bogdan-folea/explorer/doc/abstract.tex

\thispagestyle{empty}
\begin{flushleft}

\vspace*{100px}

\justify\large\textit{
    Lucrarea de față are în vedere proiectarea, asamblarea și programarea unui robot telecomandat semiautonom având la bază un sistem de operare în timp real, cu scopul de a colecta informații despre mediul înconjurător și a le transmite mai departe către un calculator. Acest lucru a fost realizat în scopul explorării unor medii în care accesul uman este restricţionat.
}

\end{flushleft}
