bogdan-folea/explorer/doc/coperta.tex

\thispagestyle{empty}
\begin{center}

{\large
    UNIVERSITATEA POLITEHNICA DIN BUCUREȘTI \\
    FACULTATEA DE AUTOMATICĂ ȘI CALCULATOARE \\
    DEPARTAMENTUL DE CALCULATOARE \\
}

\vspace{\stretch{1}}

\begin{tabular}{m{0.28\linewidth}m{0.4\linewidth}m{0.22\linewidth}}
%\flushleft 
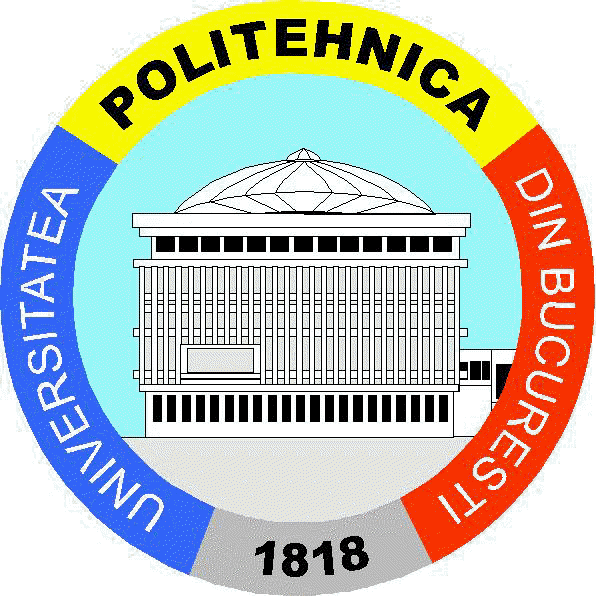
[picture p1: doc/figuri/upb-logo.png]
\center  &
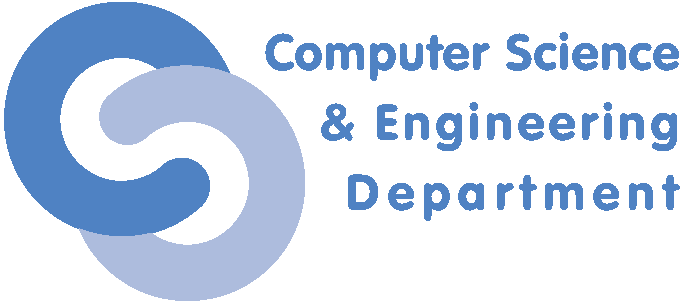
[picture p2: doc/figuri/cs-logo.png]
\center  &
%\flushright 
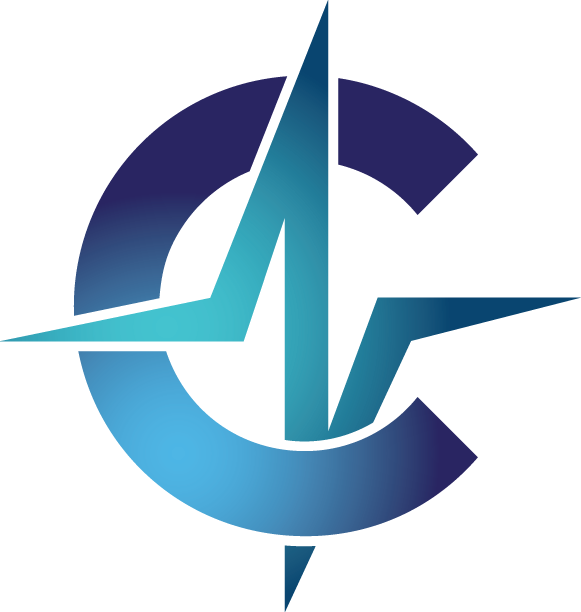
[picture p3: doc/figuri/acs-logo.png]
\center 
\end{tabular}

\vspace{\stretch{12}}

{\LARGE
	\textbf{LUCRARE DE DIPLOMĂ}\\
	\vspace{\stretch{3}}
	\textbf{Robot Explorator}
}

\vspace{\stretch{8}}

{\large
    \begin{multicols}{2}
        \begin{flushleft}
        \textbf{Coordonatori științifici:}\\
        Prof.dr.ing. Mariana Mocanu\\
        \fbox{Prof.dr.ing. Șerban Petrescu}
        \end{flushleft}
    \columnbreak
        \begin{flushright}
        \textbf{Absolvent:}\\
        Bogdan Folea
        \end{flushright}
    \end{multicols}
}

\vspace{\stretch{20}}

{\large
    \textbf{BUCUREȘTI\-\ \-\ \-\ }\\
    - 2017 -
}

\end{center}
