bogdan-folea/explorer/doc/bibliografie.tex

\clearpage
\addcontentsline{toc}{chapter}{Bibliografie}

\begin{thebibliography}{99}

    % Introducere
    \bibitem{heron}{
        N. Sharkey, \emph{A programmable robot from AD 60}, New Scientist, 2007.
    }
    \bibitem{curiosity}{
        M. Wall, 
        \emph{A Glitch Nearly Killed NASA's Curiosity Rover After 6 Months on Mars}, 2017. Disponibil pe 
        \href{https://www.space.com/36841-mars-rover-curiosity-computer-glitch-60-minutes.html}{www.space.com} (15.05.2017)
	}
    \bibitem{djedi}{
        R. Richardson, et al.  
        \emph{The “Djedi” Robot Exploration of the Southern Shaft of the Queen's Chamber in the Great Pyramid of Giza, Egypt}, Journal of Field Robotics 30(3): 323–348, 2013.
	}
    \bibitem{wolf}{
        M. Wolf, 
        \emph{High-Performance Embedded Computing: Applications in Cyber-Physical Systems and Mobile Computing}, 
        Second Edition, Elsevier, 2014
    }
    \bibitem{kraeling}{
        R. Oshana, M. Kraeling, 
        \emph{Software Engineering for Embedded Systems: Methods, Practical Techniques, and Applications}, 
        Elsevier, 2013
    }
	
	% Arhitectura hardware
    \bibitem{toulson}{
        R. Toulson, T. Wilmshurst, 
        \emph{Fast and Effective Embedded Systems Design -- Applying the ARM mbed}, 
        Elsevier, 2012
    }
    
    % Implementarea software
    \bibitem{walls}{
        C. Walls, 
        \emph{Embedded Software: The Works}, 
        Second Edition, Elsevier, 2012
    }
    \bibitem{barr}{
        M. Barr, 
        \emph{Programming Embedded Systems in C and C++}, 
        O'Reilly, 1999
    }
    \bibitem{ritchie}{
        B. Kernighan, D. Ritchie, 
        \emph{The C programming Language}, 
        Second Edition, Prentice-Hall, 1988
    }
    \bibitem{noergaard}{
        T. Noergaard, 
        \emph{Embedded Systems Architecture}, 
        Elsevier, 2013
    }
    \bibitem{freertos1}{
        R. Barry, 
        \emph{Using the FreeRTOS Real Time Kernel}, 
        Real Time Engineers Ltd, 2010
    }
    \bibitem{lee}{
        E. Lee, S. Seshia, 
        \emph{Introduction to Embedded Systems -- A Cyber-Physical Systems Approach}, 
        LeeSeshia.org, 2011
    }
    \bibitem{cortexm}{
        J. Yiu, 
        \emph{The Definitive Guide to ARM Cortex--M3 and Cortex--M4 Processors}, 
        Third Edition, Elsevier, 2014
    }
    \bibitem{freertos2}{
        R. Barry, 
        \emph{Mastering the FreeRTOS Real Time Kernel}, 
        Real Time Engineers Ltd, 2016
    }

\end{thebibliography}
