bogdan-folea/explorer/doc/anexe/circuit.tex

\chapter{Schema electrică}

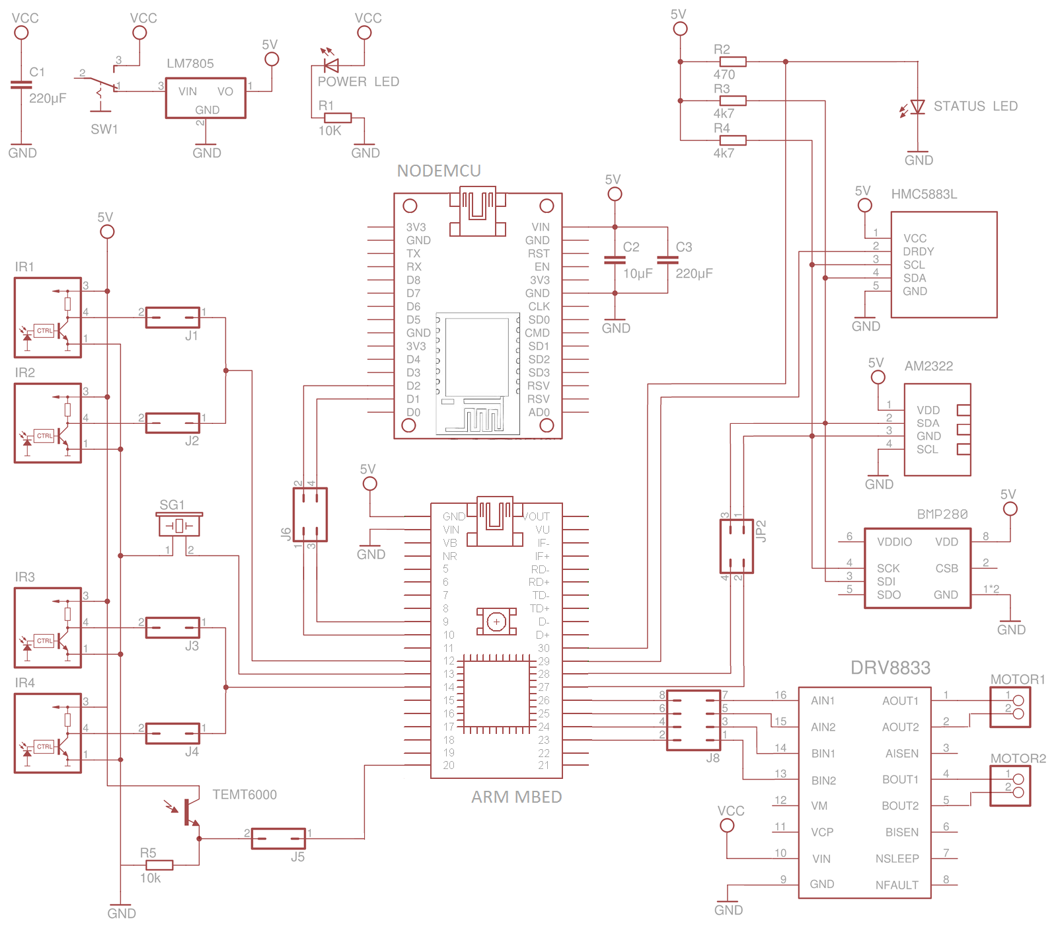
[picture p4: doc/figuri/schema.png]
\center
