bogdan-folea/explorer/doc/lucrare.pdf

### UNIVERSITATEA POLITEHNICA DIN BUCURES, TI FACULTATEA DE AUTOMATICA S ˘ , I CALCULATOARE DEPARTAMENTUL DE CALCULATOARE


## LUCRARE DE DIPLOMA˘

## Robot Explorator

Coordonatori s,tiint,ifici:

### Prof.dr.ing. Mariana Mocanu Prof.dr.ing. S, erban Petrescu

Absolvent:

### Bogdan Folea

BUCURES, TI
- 2017 -

Lucrarea de fat,˘a are în vedere proiectarea, asamblarea s,
i programarea unui
robot telecomandat semiautonom având la baz˘a un sistem de operare în timp real, cu scopul de a colecta informat,

ii despre mediul înconjur˘ator s, i a
le transmite mai departe c˘atre un calculator. Acest lucru a fost realizat în scopul explor˘arii unor medii în care accesul uman este restric¸tionat.

# Cuprins

1 Introducere | 3
2 Arhitectura hardware | 9

Cuprins

3 Implementarea software | 23
4 Rezultate experimentale | 35
5 Concluzii s,i dezvoltare ulterioar ˘a | 37
Bibliografie | 38
List ˘a de figuri | 39
Anexa A Schema electric ˘a | 41

# Capitolul 1

# Introducere

Istoria robot,ilor îs, i are originile în Antichitatea clasic ˘a, fapt dovedit de scrierile matematicianului Heron din Alexandria, care stau m ˘arturie existent,ei unor mecanisme automate [1] bazate pe principii mecanice. Fascinat,ia pentru construct,ia unor astfel de mecanisme s-a manifestat s, i în perioada Renas,terii italiene, prin schit,ele lui Leonardo da Vinci s, i mai târziu în timpul Revolut,iei Industriale.

Momentul de cotitur ˘a în acest domeniu îl constituie dezvoltarea electronicii s, i aparit,ia circuitelor integrate digitale, în urma c ˘aruia a s-a cristalizat s,tiint,a care se ocup ˘a cu proiectarea, construct,ia s, i operarea robot,ilor, precum s, i sistemele de control, react,ie la stimuli exteriori s, i procesare a informat,iei, sub numele de robotic ˘a.

Aceast ˘a ramur ˘a a tehnicii a cunoscut o ascensiune vizibil ˘a în trecutul recent, o dat ˘a cu aparit,ia Inteligent,ei Artificiale s, i a Internetului Obiectelor (engl. IoT¹ ),
conducând efectiv la integrarea circuitelor electronice cu sitemul de locomot,ie al robotului s, i posibilitatea de a conecta între ele mai multe astfel de sisteme autonome prin intermediul diverselor protocoale de comunicat,ii.

În prezent, datorit ˘a progreselor rapide înregistrate în domeniu, robot,ii au ajuns s ˘a îndeplineasc ˘a funct,ii din ce în ce mai diverse. Printre acestea se num ˘ar ˘a fabricarea de automobile, unde au ajuns s ˘a aib ˘a o pondere tot mai mare, sub forma liniilor de product,ie complet automatizate, au ajuns s ˘a aib ˘a o pondere tot mai mare pe parcursul ultimelor decenii. De asemenea, robot,ii au ajuns s ˘a fie folosit,i extensiv s, i la împachetarea produselor alimentare, transportul m ˘arfurilor

1
Internet of Things

Capitolul 1. Introducere

în interiorul spat,iilor de depozitare, recolta anumitor culturi de fructe, fabricarea cablajelor imprimate, precum s, i în exploat ˘ari miniere. Pe lâng ˘a tipurile de robot,i industriali enumerate mai devreme, s-au dezvoltat robot,i care pot duce independent la îndeplinire sarcini domestice ca tunsul ierbii sau aspirarea covoarelor s, i, nu în ultimul rând, robot,i umanoizi, care au scopul de a imita comportamentul oamenilor sau p ˘art,i din acesta, de exemplu mersul biped.

Spre deosebire de situat,iile ment,ionate anterior, unde robot,ii sunt folosit,i cu scopul de a spori productivitatea unor activit ˘at,i ce pot fi efectuate de agent,i umani, exist ˘a împrejur ˘ari, care, prin natura lor, care impun folosirea unui robot. Poate cel mai bun exemplu este explorarea mediilor fizic inaccesibile oamenilor, aflate la mare distant, ˘a sau având indici de risc care dep ˘as, esc valori considerate admise, punând astfel în pericol o eventual ˘a intervent,ie uman ˘a. Câteva exemple sunt interiorul conductelor, spat,iul cosmic s, i mediile vulcanice sau puternic radioactive. Robot,ii special construit,i cu scopul de a explora astfel de medii se încadreaz ˘a în categoria robot,ilor exploratori.

## 1.1 Motivat,ie

Nivelul actual de dezvoltare a roboticii conduce la o popularitate în cres,tere a robot,ilor exploratori în rândul comunit ˘at,ii s,tiint,ifice s, i ingineres,ti. Fie c ˘a este vorba despre robot,i exploratori teres,tri, satelit,i artificiali sau drone, utilit ˘at,ile acestora sunt nenum ˘arate s, i se reflect ˘a în num ˘arul impresionant de cercet ˘ari privind explorarea spat,iilor de orice natur ˘a s, i fascinat,ia pe care o exercit ˘a asupra unei vaste categorii de oameni. Caracteristice acestor robot,i sunt sistemele complicate necesare pentru a îndeplini chiar sarcini foarte simple, acoperind o multitudine de discipline diferite printre care se num ˘ar ˘a mecanica, electronica, telecomunicat,iile s, i programarea.

La baza complexit ˘at,ii robot,ilor exploratori st ˘a o varietate de constrângeri care se manifest ˘a în moduri diferite în fiecare caz în parte. În particular, o dron ˘a are nevoie de m ˘asur ˘atori foarte precise ale înclin ˘arii s, i accelerat,iei, precum s, i de un metod ˘a eficient ˘a de anulare a zgomotului, în timp ce calitatea cea mai important ˘a a unui robot destinat explor ˘arii spat,iului cosmic este fiabilitatea. Un exemplu elocvent în acest caz este robotul Curiosity al Agent,iei Spat,iale Americane (engl. NASA²
), lansat în noiembrie 2011 pentru a explora planeta Marte.

2National Aeronautics and Space Administration

1.1. Motivat,ie

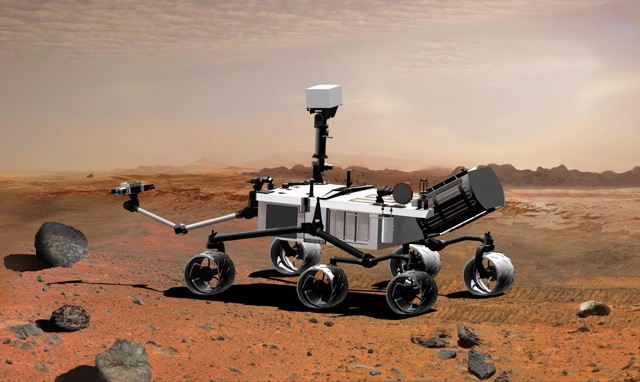
[picture p5: figure]

Figura 1.1: Robotul explorator Curiosity al NASA

La doar s, ase luni de la aterizarea acestuia, o eroare în memoria pilotului principal, combinat ˘a cu defectarea simultan ˘a a mecanismelor de sigurant, ˘a a condus la un potent,ial dezastru [2] însemnând pierderea definitiv ˘a a întregii investit,ii de 2,5 miliarde de dolari americani.

Comun ˘a tuturor sistemelor mai sus amintite este constrângerea de timp real (engl. real-time constraint) la care sunt supuse, definit ˘a garant,ia r ˘aspunsului la un stimul exterior înaintea unui termen limit ˘a prestabilit, indiferent de înc ˘arcarea sistemului. Solut,ia elegant ˘a la aceast ˘a problem ˘a este oferit ˘a de sistemele de operare în timp real (engl. RTOS³
).

Dezvoltarea în ultimul deceniu a sistemelor de operare în timp real se datoreaz ˘a în mare parte cres,terii puterii de procesare a microcontrollerelor, rezultând în folosirea mai eficient ˘a a timpului de calcul. Întrucât o schimbare de context⁴ dureaz ˘a foarte put,in (ordinul microsecundelor), sistemele de operare actuale nu mai sunt constrânse de frecvent,a cu care apare, ceea ce conduce la un timp de r ˘aspuns îmbun ˘at ˘at,it semnificativ.

În momentul de fat, ˘a exist ˘a o multitudine de astfel de sisteme de operare, sub licent, ˘a proprietar ˘a sau open source. Dintre acestea din urm ˘a cel mai popular este FreeRTOS, dezvoltat de Real Time Engineers Ltd., a c ˘arui descriere detaliat ˘a se g ˘ases,te în lucrarea de fat, ˘a la capitolul aferent. Acesta prezint ˘a un num ˘ar mare de avantaje care îl recomand ˘a, printre care faptul c ˘a e orientat pe evenimente, simplitatea interfet,ei de acces (engl. API⁵
), documentat,ia clar˘a s, i abundent ˘a, precum s, i suportul on-line de calitate.

3Real-Time Operating System
4Schimbarea execu¸tiei unui proces cu un altul pe procesor 5Application Programming Interface

Capitolul 1. Introducere

Posibilitatea de a utiliza acest sistem de operare în timp real, flexibil s, i asincron, la baza unui robot explorator în scopul de a folosi eficient timpul de calcul s, i a obt,ine un timp bun de r ˘aspuns la comenzi sau stimuli exteriori constituie motivat,ia din spatele realiz ˘arii acestui proiect.

## 1.2 Scopul lucr ˘arii

Lucrarea de fat, ˘a are drept scop proiectarea, asamblarea s, i programarea unui robot explorator operat de la distant, ˘a, destinat mediului terestru. Acesta trebuie s ˘a m ˘asoare o varietate de parametri caracteristici mediului înconjur ˘ator precum temperatura, presiunea, umiditatea s, i intensitatea luminii ambientale s, i s ˘a transmit ˘a datele operatorului. În plus, este necesar ca acesta s ˘a react,ioneze autonom în situat,ii de risc ce îi pun în pericol integritatea. G ˘asirea unei modalit ˘at,i eficiente de a garanta c ˘a atât r ˘aspunsul la comenzile de deplasare, cât s, i transferul continuu al datelor se petrec în timp real, face, de asemenea, obiectul acestei lucr ˘ari.

## 1.3 Stadiul actual

Un robot destinat explor ˘arii terestre este dotat cu rot,i sau, cel mai frecvent, montat pe un s, asiu cu s, enile, ceea ce îi confer ˘a mobilitate s, i stabilitate crescut ˘a pe terenuri accidentate s, i faciliteaz ˘a ocolirea sau dep ˘as, irea eventualelor obstacole. Un exemplu în acest sens este robotul Urbie Rover al NASA.

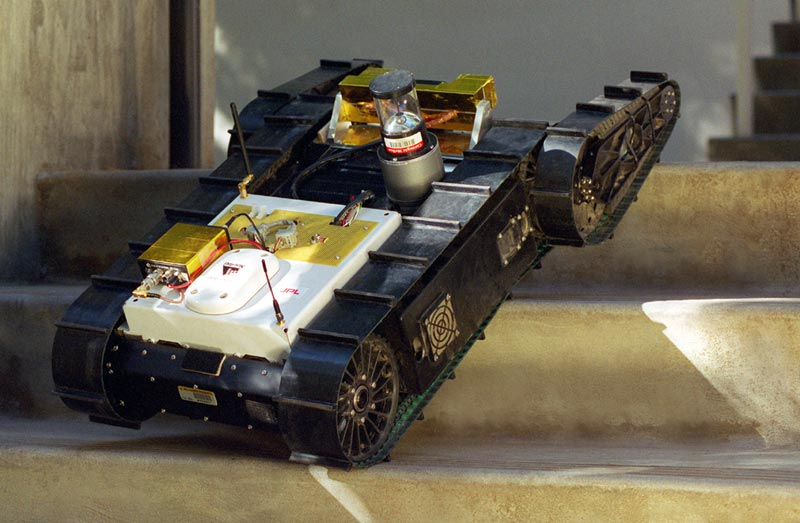
[picture p6: figure]

Figura 1.2: Robotul urban Urbie Rover al NASA

1.3. Stadiul actual

Acesta serves,te în special la explorarea mediilor urbane, caracterizate de obstacole dificil de trecut ca serii de trepte sau borduri. Este prev ˘azut cu s, enile, wireless Ethernet, receptor GPS diferent,ial, busol ˘a digital ˘a, LIDAR⁶
, o camer ˘a de
luat vederi omnidirect,ional ˘a, o pereche de camere video pentru vedere binocular ˘a s, i dou ˘a procesoare Intel Pentium PC-104. Arhitectura sa este una modular ˘a, unul din procesoare fiind rezervat pentru navigat,ie, iar cel ˘alalt pentru procesarea de imagini. Aceste echipamente îi ofer ˘a posibilitatea de a îndeplini autonom o varietate de sarcini, precum localizarea în spat,iu, urcarea treptelor, evitarea obstacolelor s, i reconstituirea s, i retraversarea traseului parcurs.

Cu certitudine se poate spune c ˘a, în aceast ˘a categorie, cei mai utili sunt robot,ii proiectat,i s ˘a opereze în spat,ii de dimensiuni reduse, spre exemplu în interiorul unor conducte de ventilat,ie, cu scopul de a localiza posibile defecte sau chiar în scopul cercet ˘arilor arheologice. Elocvent în acest sens este cazul robotului explorator Djedi, dezvoltat de comunitatea internat,ional ˘a de egiptologi în colaborare cu Universitatea din Leeds.

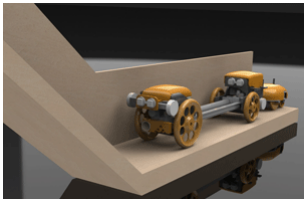
[picture p7: figure]

Figura 1.3: Robotul explorator Djedi

Un caz aparte, Djedi a fost special proiectat s, i construit în scopul de a explora put,urile de ventilat,ie din Marea Piramid ˘a a lui Kheops [3], un exemplu excelent de problem ˘a pentru care utilizarea unui robot este unica solut,ie, explorarea acestui mediu fiind cu des ˘avârs, ire imposibil de realizat folosind orice alt ˘a metod ˘a.

6Light Imaging, Detection, And Ranging

Capitolul 1. Introducere

## 1.4 Sisteme embedded

Sistemul expus în lucrarea de fat, ˘a intr ˘a în categoria sistemelor încorporate sau embedded în timp real, dedicate doar rezolv ˘arii unui anumit tip de sarcini s, i atingerii simultane a unor t,eluri cuantificabile. Este necesar ca la proiectarea unui astfel de sistem s ˘a se t,in ˘a seama de aceste t,eluri, din care cel mai important este garant,ia r ˘aspunsului în timp real, dar printre care se num ˘ar ˘a s, i consumul de energie s, i, nu în ultimul rând, costul. Cerint,ele specifice conduc inevitabil la compromisuri diferite între performant, ˘a s, i consumul de energie sau accentul predominant pus pe hardware sau software.

Contrastând puternic cu calculatoarele de uz general, unde nu se cunoas,te în prealabil modul în care vor fi folosite s, i ale c ˘aror arhitecturi trebuie s ˘a permit ˘a folosirea lor în feluri cât mai diverse, în cazul unui sistem embedded atât proiectarea hardware cât s, i software se realizeaz ˘a simultan. Prin urmare, o problem ˘a întâmpinat ˘a poate fi rezolvat ˘a în hardware, software sau o combinat,ie între cele dou ˘a. Aceste abord ˘ari implic ˘a compromisuri diferite, deci ofer ˘a un spat,iu mai mare de manevr ˘a s, i posibilitatea de a obt,ine o solut,ie calitativ mai bun ˘a, mai fiabil ˘a s, i flexibil ˘a, f ˘ar ˘a îns ˘a de a prezenta flexibilitate inutil de mare în detrimentul îndeplinirii cerint,elor. [4]

Un sistem embedded opereaz ˘a în timp real atâta timp cât execut ˘a procesele critice într-un timp acceptabil. Definit,ia flexibil˘a a acestui interval îl încadreaz ˘a ca parte a cerint,elor comportamentale ale sistemului s, i nu a celor funct,ionale. Este obligatoriu ca aceste cerint,e s ˘a fie m ˘asurabile sau cuantificabile în mod obiectiv, dar pot fi reduse la un model de administrare a resurselor ce poate fi static ˘a sau dinamic ˘a, aflat ˘a în sarcina unui programator, respectiv a unui sistem de operare. Administrarea resurselor în timp real are îns ˘a asociat un cost, deoarece este imposibil de obt,inut gradul de încredere într-un timp rezonabil de r ˘aspuns doar prin redimensionarea hardware-ului. În contextul interact,iunii cu alte dispozitive, un sistem embedded are nevoie atât de capabilit ˘at,i hardware adecvate, cât s, i de eficient, ˘a în administrarea software a resurselor. Mediul este complex s, i în continu ˘a schimbare s, i acest lucru se reflect ˘a în num ˘arul s, i ponderea interact,iunilor. Important,a maxim ˘a în acest context apart,ine evalu ˘arii corecte a timpului fizic, necesar ˘a pentru a corela evenimentele cu momentele exacte ale producerii lor, nu cea logic ˘a, asupra c ˘areia sistemele au în mod automat control. Prin urmare, caracteristica esent,ial ˘a a sistemelor embedded în timp real devine inevitabil g ˘asirea unui compromis între performant, ˘a s, i timpul definit ca acceptabil. [5]

# Capitolul 2

# Arhitectura hardware

Arhitectura hardware propus ˘a este una modular ˘a s, i prevede, în m ˘asura în care acest lucru este posibil, componente diferite pentru a îndeplini funct,ii diferite. Întregul sistem este proiectat în jurul unei unit ˘at,i responsabile de controlul robotului, reprezentat ˘a de un microcontroller (MCU) capabil de a satisface constrângerea de timp real.

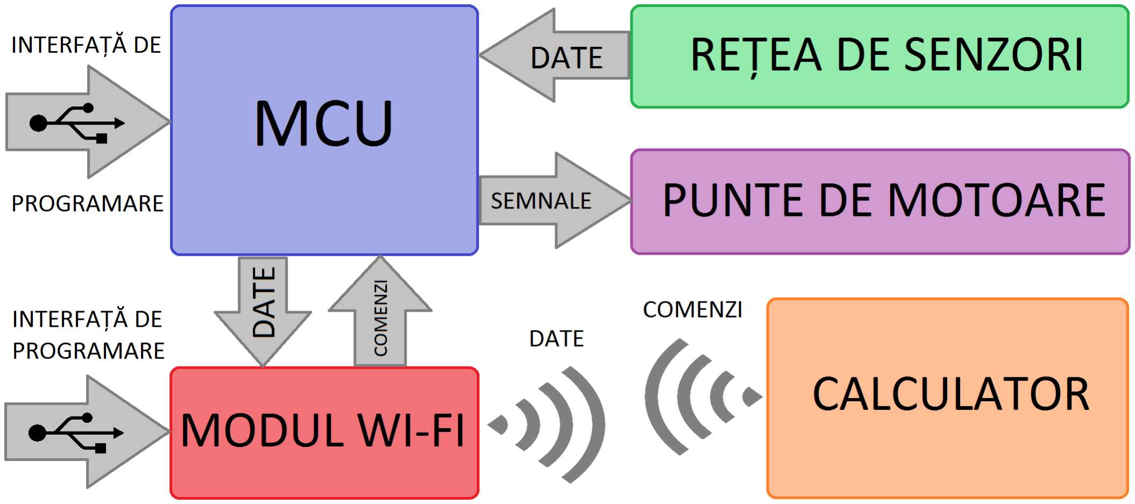
[picture p8: figure]

Figura 2.1: Schema bloc a sistemului

Direct conectat,i la aceasta sunt o serie de senzori de mai multe tipuri, reprezentând o important ˘a parte a sistemului deoarece ofer ˘a informat,ii vitale despre mediul înconjur ˘ator, subansamblul responsabil cu locomot,ia, format din motoare s, i puntea de control montate pe un s, asiu, s, i un modul Wi-Fi responsabil de comunicat,ia cu calculatorul. Aceasta presupune atât transmisia datelor dinspre microcontroller c ˘atre calculator, cât s, i cea în sens invers a comenzilor de deplasare.

Capitolul 2. Arhitectura hardware

La proiectarea robotului am luat în calcul alocarea cât mai eficient ˘a a fiec ˘arei sarcini, p ˘astrând în acelas, i timp coerent,a întregului sistem s, i având totodat ˘a în vedere disponibilitatea pe piat, ˘a a unor componente dedicate special îndeplinirii lor. În urma acestui proces am decis separarea principalelor funct,ii ale robotului conform schemei de mai sus.

Potrivit acestei abstractiz ˘ari, microcontrollerul îndeplines,te funct,iile de comand ˘a s, i control, precum s, i cea de asamblare a datelor despre mediu într-un mod consistent s, i predictibil. De asemenea, interpreteaz ˘a informat,ii s, i comenzi, având, în anumite situat,ii, rol decizional. Acest lucru confer ˘a robotului adaptabilitate la condit,ii schimb ˘atoare în mediu, spre exemplu comanda de oprire în cazul detect,iei un obstacol aflat pe direct,ia de mers sau react,ia atunci când este afectat ˘a funct,ionarea unui senzor.

Funct,ia de achizit,ie a datelor este îndeplinit ˘a de senzori specializat,i care trimit m ˘asur ˘atori spre a fi asamblate de microcontroller. Locomot,ia robotului cade în sarcina motoarelor s, i a punt,ii de control, iar transferul de date c ˘atre calculator s, i primirea comenzilor sunt realizate de modulul Wi-Fi, având rolul de interfat, ˘a a microcontrollerului.

În cele ce urmeaz ˘a sunt descrise componentele hardware ale robotului s, i este motivat ˘a alegerea fiec ˘areia pentru a îndeplini una din funct,iile de mai sus. În acest scop am t,inut seama, pe lâng ˘a cerint,ele tehnice, de consumul de energie, de cost s, i de existent,a unei interfet,e convenabile de programare.

## 2.1 Controlul robotului

Principala component ˘a responsabil ˘a de controlul robotului este platforma ARM mbed, proiectat ˘a s, i fabricat ˘a de compania NXP Semiconductors N.V. Aceasta este dezvoltat ˘a în jurul unui microcontroller LPC1768, la rândul s ˘au bazat pe microprocesorul ARM Cortex–M3.

Alegerea acestei platforme se datoreaz ˘a atât puterii de procesare, cât s, i a us,urintei de a fi programat ˘a. Având în component, ˘a un adaptor USB¹ conectat
direct la memoria flash, platforma poate fi reprogramat ˘a prin copierea direct ˘a a codului binar obt,inut la cross-compilare. [6]

1Universal Serial bus

2.1. Controlul robotului

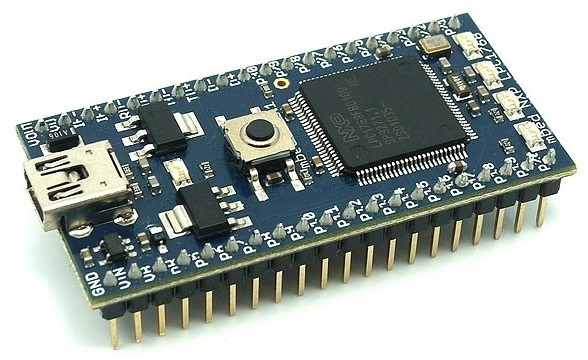
[picture p9: figure]

Figura 2.2: Platforma NXP mbed LPC1768

### 2.1.1 Procesorul ARM Cortex–M3

Platforma are la baz ˘a microprocesorul pe 32 de bit,i ARM Cortex–M3 ce implementeaz ˘a arhitectura setului de instruct,iuni (engl. ISA²
) ARMv7-M Thumb-2.
Acesta, similar cu celelalte procesoare din seria Cortex-M, prezint ˘a caracteristici tehnice [6] care îl recomand ˘a pentru un proiect de tipul descris în lucrarea de fat, ˘a, printre care un num ˘ar mare al liniilor de întreruperi externe (configurabil; pân ˘a la 240), reprioritizare dinamic ˘a a întreruperilor, latent, ˘a redus ˘a la intrarea s, i ies, irea din rutine de tratare a întreruperilor (engl. ISR³
), acces la memorie s, i regis,tri de sistem pentru depanare (engl. debugging), frecvent,a ridicat ˘a de operare de pân ˘a la 100 MHz, consumul mic de energie s, i comportamentul determinist.

### 2.1.2 Microcontrollerul LPC1768

În plus fat, ˘a de avantajele procesorului amintite mai sus, microcontrollerul LPC1768, bazat pe acesta, integreaz ˘a o memorie volatil ˘a de 64kB s, i o memorie de program de 512kB [6], precum s, i posibilitatea de a fi reprogramat f ˘ar ˘a a fi izolat de sistem (engl. ISP⁴
), as, a cum am ment,ionat la începutul acestui capitol. De asemenea, num ˘arul mare de periferice îl recomand ˘a pentru acest proiect, fiind în mod special utile convertorul analog-numeric (engl. ADC⁵

), interfat,a I2C⁶
,
interfat,a serial ˘a UART⁷

s, i modularea în factor de umplere (engl. PWM⁸ ).

2
Instruction Set Architecture
3
Interrupt Service Routine
4
In-System Programming
5Analog-to-Digital Converter

6
Inter-Integrated Circuit
7Universal Asynchronous Receiver/Transmitter 8Pulse-Width Modulation

Capitolul 2. Arhitectura hardware

## 2.2 Locomot,ia

Robotul este construit pe un s, asiu cu s, enile, fiecare dintre acestea act,ionat ˘a de câte un motor în curent continuu de mici dimensiuni, caracterizat de tensiunea nominal ˘a de 9V s, i puterea consumat ˘a de 0.6W la capacitate maxim ˘a. Prin intermediul unor angrenaje se realizeaz ˘a transmisia c ˘atre ultima pereche de rot,i care antreneaz ˘a, mai departe, s, enilele.

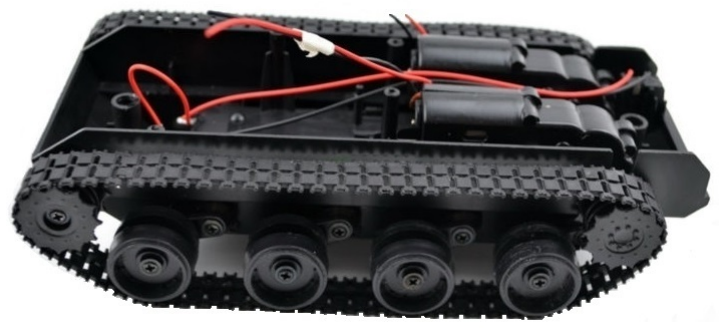
[picture p10: figure]

Figura 2.3: S, asiul robotului s, i motoarele

### 2.2.1 Controlul vitezei

Pentru controlul vitezei acestora se utilizeaz ˘a capabilitatea de modulare în factor de umplere (PWM) a microcontrollerului LPC1768. Avantajele acestei abord ˘ari sunt disiparea redus ˘a de putere s, i posibilitatea motoarelor de a fi comandate s ˘a se mis,te cu viteze reduse, f ˘ar ˘a ca acest lucru s ˘a conduc ˘a la oprirea lor complet ˘a.

Deoarece motoarele în curent continuu au nevoie, pentru scurt timp dup ˘a pornire, de curent,i mari, acestea au fost prev ˘azute cu condensatori ceramici. Din acelas, i motiv, a fost instalat s, i un condensator electrolitic de capacitate mai mare la alimentare, pentru a nu afecta funct,ionarea circuitelor integrate.

### 2.2.2 Controlul direct,iei

Direct,ia de deplasare a robotului este determinat ˘a de viteza relativ ˘a s, i sensul de deplasare ale fiec ˘areia dintre cele dou ˘a s, enile. Dac ˘a acestea au viteze egale s, i acelas, i sens de deplasare, robotul se va mis, ca în linie dreapt ˘a, iar dac ˘a vitezele sunt diferite, traiectoria urmat ˘a se va curba spre cea cu viteza mai mic ˘a. În cazul în care sensurile de deplasare sunt opuse, acesta se va roti în jurul propriei axe.

2.2. Locomot,ia

Controlul direct,iei se realizeaz ˘a prin intermediul unui circuit electronic cunoscut sub numele de punte H, ce permite aplicarea unei tensiuni pe o sarcin ˘a, în cazul de fat, ˘a un motor, în orice sens, determinând sensul de rotire al motorului.

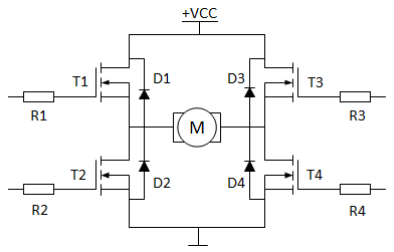
[picture p11: figure]

Figura 2.4: Exemplu de punte H

În general, o punte H este construit ˘a din 4 tranzistori, de obicei MOSFET⁹ ,
dispus, i ca în figura de mai sus. Motorul este în funct,iune atunci când o pereche de tranzistori opus, i (în figura de mai sus T1,T4 sau T2,T3) este deschis ˘a iar cealalt ˘a este blocat ˘a. Inversarea polarit ˘at,ii motorului se obt,ine prin închiderea unei perechi de tranzistori opus, i s, i deschiderea simultan ˘a a celeilalte. Tranzistorii de pe aceeas, i parte a punt,ii nu trebuie s ˘a fie simultan deschis, i, deoarece în acest fel rezult ˘a un scurtcircuit la sursa de tensiune. Dac ˘a puntea este proiectat ˘a cu tranzistori bipolari, perechea de sus trebuie s ˘a fie PNP în conexiune emitor la sursa de tensiune, respectiv NPN în conexiune emitor la punctul de mas ˘a în cazul perechii de jos. Pentru factori de amplificare mari se adaug ˘a rezistent,e la intrarea în baz ˘a.

În plus, majoritatea punt,ilor sunt prev ˘azute cu diode de protect,ie legate în paralel la fiecare tranzistor, invers raportat la sensul c ˘aderii de tensiune, conform figurii de mai sus. În acest fel, la închiderea ambelor perechi de comutatoare, curentul invers produs de rotat,ia inert,ial ˘a a motorului se va putea scurge prin diodele ce au o impedant, ˘a comparativ mai mic ˘a s, i nu prin tranzistori, evitând distrugerea acestora s, i disipând energia sub form ˘a de c ˘aldur ˘a.

9Metal–Oxide–Semiconductor Field-Effect Transistor

Capitolul 2. Arhitectura hardware

### 2.2.3 Puntea de motoare DRV8833

Punt,ile H sunt disponibile sub forma unor circuite integrate sau pot fi construite din componente discrete. Un avantaj al primelor fat, ˘a de cele din urm ˘a este spat,iul mic pe care îl ocup ˘a. Din acest motiv, în cazul de fat, ˘a a fost preferat ˘a folosirea punt,ii duble DRV8833, proiectat ˘a s, i construit ˘a de Texas Instruments.

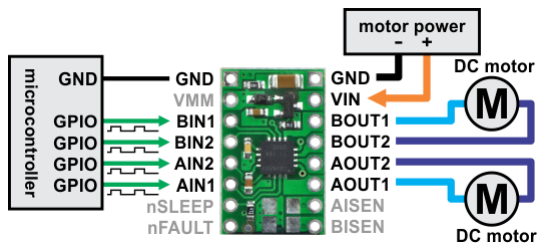
[picture p12: figure]

Figura 2.5: Puntea de motoare DRV8833

Aceasta integreaz ˘a dou ˘a punt,i H, deci poate fi folosit ˘a la controlul direct,iei ambelor motoare, iar caracteristicile sale tehnice sunt mai mult decât adecvate proiectului de fat, ˘a. În plus, prezint ˘a avantajul disip ˘arii eficiente a c ˘aldurii.

## 2.3 Detect,ia obstacolelor

Este necesar ca un robot explorator s ˘a prezinte un anumit grad de autonomie, în sensul c ˘a trebuie s ˘a fie capabil sa act,ioneze pe baza impulsurilor provenite din exterior. Cea mai mare important, ˘a în acest sens o are mecanismul de de detect,ie a obstacolelor, pentru realizarea c ˘areia se folosesc, în general, senzori de proximitate, definit,i ca acei senzori ce pot detecta prezent,a unor obiecte din apropierea lor f ˘ar ˘a a intra fizic în contact cu ele.

Un senzor de proximitate tipic are emite radiat,ie electromagnetic ˘a, de obicei în spectrul infraros,u (IR), verificând dac ˘a exist ˘a modific ˘ari în câmpul electromagnetic al receptorului. Un obiect pozit,ionat în raza senzorului va reflecta radiat,ia, ducând astfel la detect,ia sa de c ˘atre senzor. Pentru elimina interferent,ele, receptorul este, de regul ˘a, prev ˘azut cu un filtru ce permite s ˘a treac ˘a doar radiat,ia IR. Fires,te c ˘a un obiect poate fi detectat doar în cazul în care reflect ˘a undele IR. În cazuri speciale se pot folosi senzori ce au la baz˘a principii de funct,ionare diferite,

2.4. Orientarea în spat,iu

de exemplu senzori ultrasonici sau inductivi, îns ˘a aces,tia au asociate mai multe restrict,ii. Cei dintâi nu pot detecta suprafet,e foarte moi, ca materialele textile, iar cei din urm ˘a obiecte ce nu sunt metalice. Drept urmare, utilizarea senzorilor IR este, în cazul de fat, ˘a, cea mai adecvat ˘a.

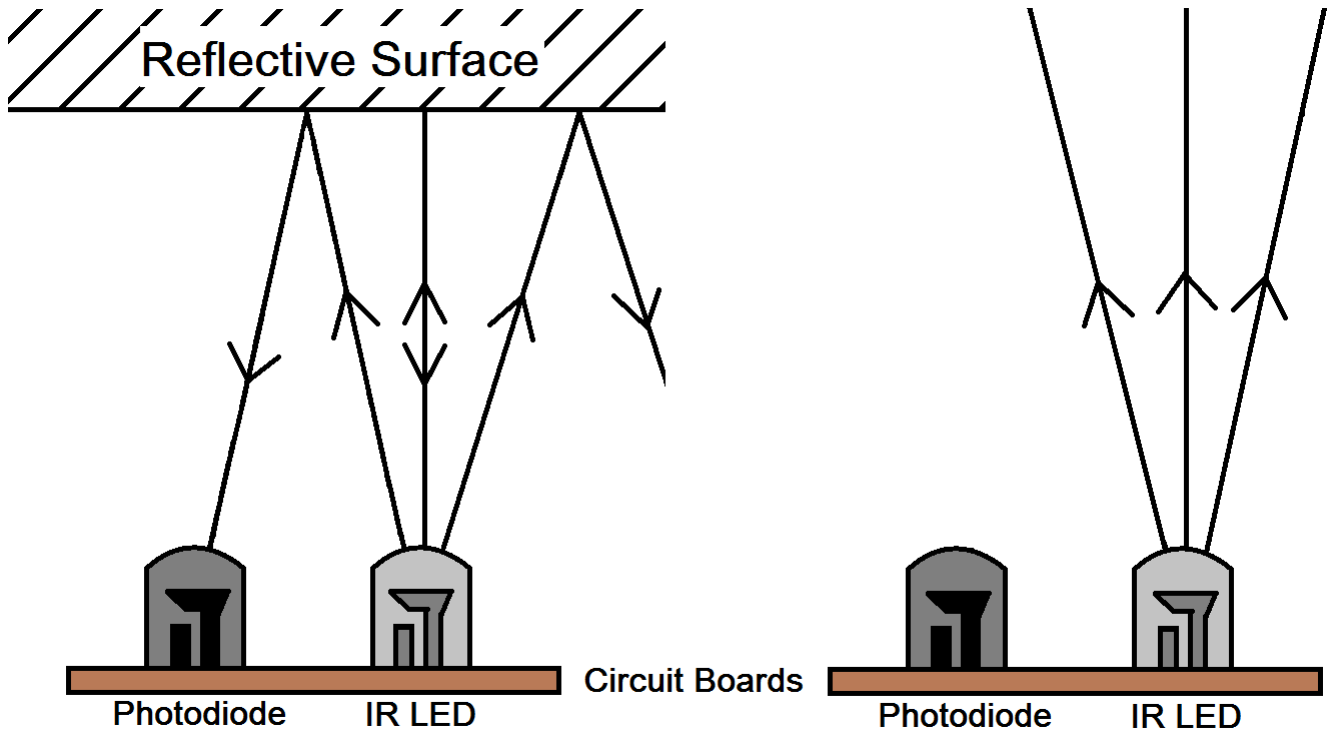
[picture p13: figure]

Figura 2.6: Principiul de funct,ionare al unui senzor de proximitate IR

Cea mai mare parte a senzorilor IR pot detecta nu doar prezent,a unui obiect în raz ˘a, dar si distant,a aproximativ ˘a la care acesta se afl ˘a. La baza acestei capabilit ˘at,i st ˘a o lentil ˘a sau o fant ˘a pozit,ionat ˘a imediat în fat,a unui receptor cu o suprafat, ˘a mai mare. Când un fascicul IR intr ˘a în receptor sub un unghi oarecare va activa o anumit ˘a parte a receptorului, f ˘acând posibil ˘a identificarea unghiului de incident, ˘a deci, cunoscând distant,a între emit, ˘ator s, i receptor, s, i a distant,ei parcurs ˘a de unda luminoas ˘a, aproximativ egal ˘a cu dublul distant,ei pân ˘a la obiectul detectat. Ies, irea circuitului în acest caz este un semnal analogic, care, dac ˘a se consider ˘a necesar, poate fi transformat într-un semnal digital utilizând un comparator s, i un potent,iometru.

## 2.4 Orientarea în spat,iu

Pentru orice dispozitiv mobil, localizarea este o funct,ie important ˘a. De multe ori este necesar ca un robot s ˘a cunoasc ˘a pozit,ia sa exact ˘a într-un sistem de referint, ˘a, precum s, i orientarea sa în spat,iu. O astfel de situat,ie poate fi folosirea unui robot pentru cartografierea unui anumit mediu.

În prezent exist ˘a numeroase metode de localizare, din care cea mai popular ˘a este prin GPS¹⁰. Acesta este un sistem global de navigat,ie prin satelit s, i unde

10Global Positioning System

Capitolul 2. Arhitectura hardware

radio, bazat pe o ret,ea de satelit,i artificiali ce orbiteaz ˘a în puncte fixe deasupra P ˘amântului s, i transmit semnale cont,inând un marcaj de timp s, i un cod de pozit,ionare geografic ˘a tuturor receptorilor aflat,i la sol. Orice receptor GPS aflat în raza neobstruct,ionat ˘a a cel put,in patru satelit,i din ret,ea îs, i poate calcula pozit,ia cu o precizie de ordinul metrilor.

Alternativ, pozit,ia poate fi calculat ˘a folosind num ˘arul de rotat,ii ale rot,ilor, cunoscându-se diametrul lor, sau integrând accelerat,ia momentan ˘a m ˘asurat ˘a de un accelerometru. Aceste metode sunt susceptibile, îns ˘a, la erori, din cauz ˘a c ˘a pot exista derapaje s, i precizia m ˘asur ˘atorilor accelerometrului este afectat ˘a de zgomot, chiar în prezent,a unui mecanism de filtrare eficient. Drept urmare, aceste metode nu sunt adecvate robotului descris în lucrarea de fat, ˘a, prima din pricina faptului c ˘a nu poate produce rezultate la scar ˘a, iar cele din urm ˘a deoarece erorile se cumuleaz ˘a în timp, conducând la date irelevante.

O ultim ˘a metod ˘a este utilizarea unor marcaje plasate în prealabil s, i identificarea lor de c ˘atre robot, ca de exemplu urm ˘arirea unei linii. Aceasta este o metod ˘a eficient ˘a, dar nepotrivit ˘a în cazul de fat, ˘a, dat fiind c ˘a la explorarea unui mediu nou nu se poate garanta existent,a unor astfel de marcaje.

Spre deosebire de pozit,ie, orientarea în spat,iu se poate obt,ine în cele mai multe situat,ii cu o precizie convenabil ˘a prin m ˘asurarea induct,iei magnetice a P ˘amântului cu o busol ˘a digital ˘a. Am ales pentru acest proiect magnetometrul HMC5883L, fabricat de Honeywell, ce are în component,a sa senzori magnetici anizotropici pe trei axe, rezistent,i la zgomot. Alte caracteristici tehnice utile includ funct,ia de auto-calibrare, interfat,a de comunicare I2C, convertorul analog-numeric (ADC) s, i dimensiunile reduse.

## 2.5 Achizit,ia de date

Dat fiind c ˘a scopul final al unui robot explorator este achizit,ia s, i înregistrarea datelor despre mediul înconjur ˘ator, se impune ca acesta s ˘a poat ˘a m ˘asura o varietate de parametri. Spre deosebire modelul uman echivalent, în care senzat,ia nu este neap ˘arat condit,ionat ˘a de natura parametrilor, m ˘asurarea artificial ˘a presupune ca aces,tia s ˘a fie cuantificabili. Din acest motiv, procesul de m ˘asurare, a c ˘arui abstractizare este ilustrat ˘a mai jos, implic ˘a es, antionarea m ˘arimilor caracteristice mediului s, i conversia analog-numeric ˘a în vederea manipul ˘arii lor de c ˘atre un sistem de calcul.

2.5. Achizit,ia de date

Responsabil ˘a de translatarea parametrilor fizici ai mediului la semnale electrice este o ret,ea de senzori specializat,i, subsisteme electronice cu rolul de a recept,iona, identifica s, i cuantifica evenimente sau schimb ˘ari din mediu.

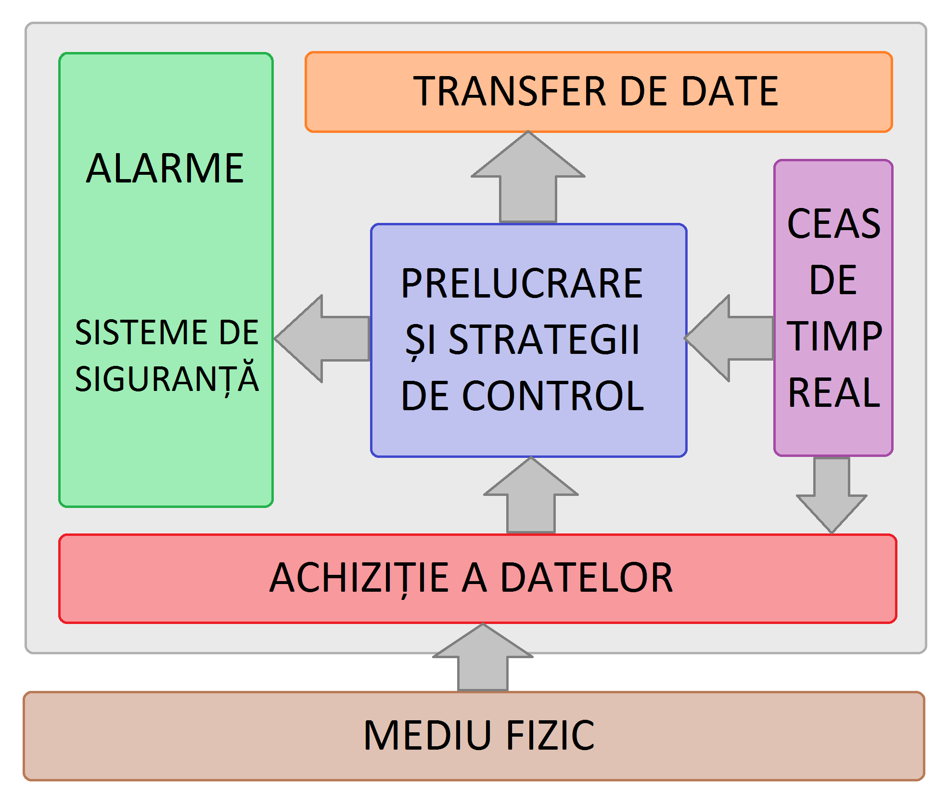
[picture p14: figure]

Figura 2.7: Sistem de calcul s, i achizit,ie a datelor în timp real

Fiecare dintre aces,tia este destinat unui anumit tip de stimul exterior la care trebuie s ˘a r ˘aspund ˘a. Informat,iile obt,inute sunt trimise mai departe microcontrollerului pentru a fi prelucrate, acolo unde este cazul, s, i asamblate într-un mod coerent. Acestea sunt mai departe transmise prin intermediul unui calculator c ˘atre un operator uman sau folosite la funct,ionarea sistemelor de sigurant, ˘a s, i declans, area unor alarme. Sistemul de sigurant, ˘a prev ˘azut în acest proiect este evitarea ciocnirii cu obstacole pe baza m ˘asur ˘atorilor de distant, ˘a, amintit la începutul acestui capitol.

### 2.5.1 Caracteristicile mediului

Am considerat important ca robotul s ˘a poat ˘a m ˘asura cât mai mult,i parametri ai mediului înconjur ˘ator s, i cât mai variat,i, ca de exemplu temperatura, presiunea barometric ˘a, intensitatea luminii ambientale s, i umiditatea relativ ˘a. Componentele utilizate pentru îndeplinirea acestui obiectiv sunt senzori a c ˘aror funct,ie de transfer este liniar ˘a, insensibili la modificarea altor m ˘arimi fizice decât cele m ˘asurate s, i care nu influent,eaz ˘a parametrii m ˘asurat,i.

Pentru m ˘asurarea temperaturii s, i presiunii barometrice am folosit senzorul digital BMP280, produs de compania Bosch. Acesta funct,ioneaz ˘a pe principiu

Capitolul 2. Arhitectura hardware

piezorezistiv, cuantificând schimbarea impedant,ei unui semiconductor la aplicarea unei presiuni mecanice diferite. Valoarea rezultat ˘a este prelucrat ˘a de un convertor analog-numeric (ADC) s, i poate fi trimis ˘a mai departe c ˘atre microcontroller prin una din interfet,ele SPI¹¹ sau I2C, împreun ˘a cu valoarea corelat ˘a a temperaturii, calculat ˘a pe baza unor diagrame predefinite. Senzorul are o rezolut,ie corespunz ˘atoare valorilor de presiune s, i temperatur ˘a de 0.16 Pa, respectiv 0.01◦C. Aceast ˘a exactitate face posibil ˘a s, i folosirea acestuia ca altimetru, dat ˘a fiind strânsa leg ˘atur ˘a între altitudine s, i presiunea atmosferic ˘a.

Evaluarea intensit ˘at,ii luminii ambientale se realizeaz ˘a prin intermediul fototranzistorului TEMT6000, conceput de Vishay Semiconductors, sensibil la radiat,ia luminoas ˘a din spectrul vizibil. În esent, ˘a, acesta este un tranzistor bipolar încapsulat într-o matrit, ˘a transparent ˘a, astfel încât jonct,iunea baz ˘a-colector s ˘a r ˘amân ˘a expus ˘a. Radiat,ia incident ˘a elibereaz ˘a prin efect fotoelectric electroni ce sunt apoi injectat,i în baz ˘a, iar curentul rezultat este amplificat cu factorul de amplificare al tranzistorului, obt,inându-se un semnal analog.

Pentru determinarea umidit ˘at,ii relative, robotul foloses,te senzorul rezistiv AM2320, fabricat de Aosong Electronics, ce are în component, ˘a materiale organice macromoleculare s, i prezint ˘a caracteristici tehnice excelente ca r ˘aspunsul rapid, stabilitatea ridicat ˘a, plaja larg ˘a de valori m ˘asurabile s, i consumul redus de curent. Semnalul de ies, ire, transmis prin interfat,a I2C semnific ˘a umiditatea relativ ˘a (engl. RH¹²), definit ˘a ca presiunea part,ial ˘a a vaporilor de ap ˘a raportat ˘a la presiunea de echilibru pentru o temperatur ˘a dat ˘a.

### 2.5.2 Percept,ia vizual ˘a

Una din cele mai interesante s, i utile funct,ii senzoriale pe care le poate avea un robot explorator este captura de imagini sau chiar mai bine, înregistrarea unui flux de imagini. Percept,ia vizual ˘a a unui spat,iu poate oferi informat,ii valoroase despre mediul înconjur ˘ator, în special atunci când mediul explorat este inaccesibil sau îndep ˘artat. În acest scop, am prev ˘azut robotul cu o camer ˘a de luat vederi OV7670, produs ˘a de OmniVision, potrivit ˘a circumstant,elor în care acesta funct,ioneaz ˘a.

Camera reprezint ˘a o alternativ ˘a eficient ˘a la sistemele scumpe s, i sofisticate ca LIDAR, atunci când este necesar ˘a nu doar determinarea pozit,iei relative a unui

11Serial Peripheral Interface
12Relative Humidity

2.5. Achizit,ia de date

obiect, dar s, i alte caracteristici precum m ˘arimea sau forma. Am decis integrarea acestui modul în proiectul de fat, ˘a din considerente de performant, ˘a, dimensiune s, i consum de curent. Camera OV7670 optimizeaz ˘a toate aceste criterii, având la baz ˘a un de imagine CMOS¹³ capabil de captura de imagini de rezolut,ie VGA¹⁴ (640×480) cu viteza de 30 de cadre pe secund ˘a.

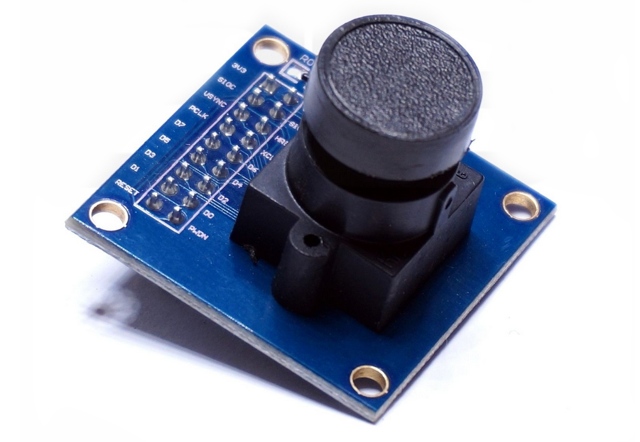
[picture p15: figure]

Figura 2.8: Camera video OV7670

Modulul ofer ˘a posibilitatea de a controla calitatea imaginii, formatul s, i rata de transfer a informat,iei, precum s, i capabilit ˘at,i de procesare ce includ controlul timpului de expunere, corect,ie gama s, i reglarea saturat,iei s, i tonalit ˘at,ii cromatice.

Pentru a evita câteva prbobleme de sincronizare, camera este prev ˘azut ˘a cu o memorie tampon (engl. FIFO¹⁵) de 3MB AL422, fabricat ˘a de AverLogic. Memoria are capabilitatea de a stoca în întregime un cadru VGA color, asigurând în acest fel evitarea problemelor de rupere a cadrelor.

Comanda acestui dispozitiv de c ˘atre microcontroller se realizeaz ˘a prin intermediul interfet,ei SCCB¹⁶, funct,ional identic ˘a cu magistrala I2C. Transmisia datelor paralel ˘a s, i sincron ˘a, utilizând 10 linii de date s, i una pentru semnalul de ceas. Din cauza faptului c ˘a interfat,a serial ˘a UART ce leag ˘a microcontrollerul de modulul Wi-Fi nu suport ˘a viteze de transfer suficient de mari, am luat decizia ca citirea imaginilor s ˘a fie realizat ˘a direct de acesta din urm ˘a, pentru a evita o eventual ˘a congestie (engl. bottleneck) a datelor pe magistrala serial ˘a.

13Complementary Metal–Oxide–Semiconductor
14Video Graphics Array
15First In, First Out
16Serial Camera Control Bus

Capitolul 2. Arhitectura hardware

## 2.6 Transferul de date

Necesitatea robotului de a comunica f ˘ar ˘a fir cu un calculator a condus la decizia de a folosi pentru transferul de date platforma IoT open source NodeMCU, bazat ˘a pe modulul Wi-Fi ESP8266, proiectat s, i fabricat de compania Espressif Systems.

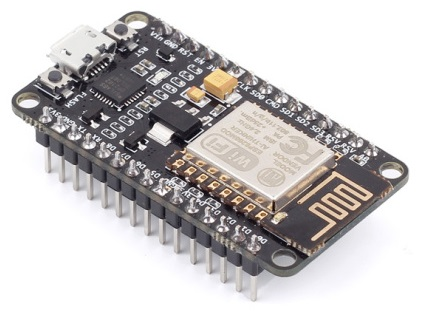
[picture p16: figure]

Figura 2.9: Platforma NodeMCU DEVKIT v1.0

Unul din argumente este reprezentat de popularitatea acestui modul în comunitate, ilustrat ˘a de aparit,ia pe piat, ˘a a unei multitudini de platforme construite în jurul s ˘au. Argumentele hot ˘arâtoare în alegerea celei mai sus amintite în detrimentul altora au fost reprogramarea facil ˘a prin intermediul adaptorului integrat USB s, i num ˘arul mare de pini, ce ofer ˘a posibilitatea interfat, ˘arii cu mai multe alte componente.

### 2.6.1 Modulul Wi-Fi ESP8266

Modulul ESP8266 este un SoC¹⁷ Wi-Fi cu stiv ˘a TCP/IP complet ˘a, bazat pe un procesor RISC¹⁸ de 32 de bit,i. Integrate în modul se afl ˘a o memorie volatil ˘a de 128kB s, i o memorie de program de 4MB, suficient pentru a-i permite s ˘a realizeze o conexiune Wi-Fi cu un calculator. Interfat,a aleas ˘a pentru a comunica cu platforma ARM mbed este UART, îns ˘a, din cauza unor erori de proiectare, nu a fost posibil ˘a folosirea capabilit ˘at,ilor hardware pentru UART ale modulului, impunând utilizarea unei implement ˘ari în software a acestei interfet,e.

17System on a chip
18Reduced Instruction Set Computer

2.7. Montajul

## 2.7 Montajul

Componentele descrise mai sus au fost lipite pe un cablaj de test de dimensiunea 16 x 10 cm, ce coincide aproximativ cu dimensiunile s, asiului, inclusiv cele dou ˘a s, enile. Drept urmare, am prev ˘azut cablajul s, i s, asiul cu trei g ˘auri adit,ionale prin care se poate face prinderea cu distant,iere s, i s,uruburi. Pentru convenient,a program ˘arii am montat distant,iere s, i în colt,urile pl ˘acii, astfel încât aceasta s ˘a poat ˘a fi as, ezat ˘a pe o mas ˘a, separat de s, asiu.

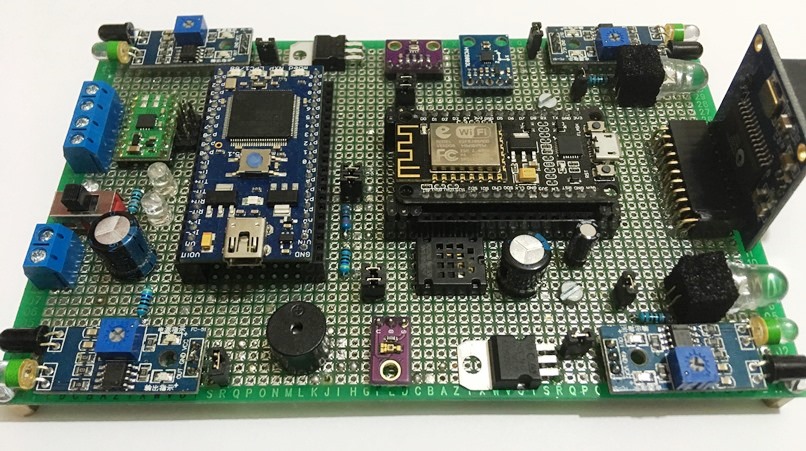
[picture p17: figure]

Figura 2.10: Montajul final – vedere lateral ˘a

Datorit ˘a dimensiunilor comparativ mari s, i a faptului c ˘a trebuie s ˘a poat˘a fi demontate de pe plac ˘a, am prev ˘azut platforma ARM mbed, modulul Wi-Fi s, i camera cu socluri adecvate. Pentru firele de alimentare am montat un suport de prindere cu s,urub s, i un întrerup ˘ator. Tensiunea maxim ˘a admis ˘a pe acestea este de 9.5V, întrucât doar puntea de motoare se alimenteaz ˘a direct, celelalte integrate fiind prev ˘azute cu regulatoare de tensiune LM7805 de 5V.

Modulul Wi-Fi funct,ioneaz ˘a la 3.3V s, i are propriul regulator de tensiune, îns ˘a pentru a evita supraînc˘alzirea acestuia pinul de alimentare este legat deopotriv ˘a la 5V. Din cauza faptului c ˘a alimentarea circuitului s, i a motoarelor este comun ˘a am montat trei condensatori înainte s, i dup ˘a regulatoarele de tensiune de 220µF, respectiv 220µF s, i 10µF. Conectarea motoarelor se realizeaz ˘a, de asemenea, prin suport,i de prindere cu s,urub, legat,i direct la ies, irile punt,ii de motoare.

Capitolul 2. Arhitectura hardware

Placa mai are în component, ˘a patru senzori IR, dispus, i longitudinal, în colt,uri, senzorii de lumin ˘a ambiental ˘a, presiune, temperatur ˘a s, i umiditate descris, i mai devreme, precum s, i un cristal piezoelectric pentru generare de semnale sonore.

Translatarea de nivel de la 5V la 3.3V a semnalului de pe magistrala UART se realizeaz ˘a prin intermediul unui divizor rezistiv de tensiune, iar liniile de ceas s, i de date ale magistralei I2C sunt legate la rezistori de pull-up de 4,7kΩ. Atât cele dou ˘a magistrale, cât s, i senzorii de proximitate s, i intr ˘arile punt,ii de motoare sunt conectate la jumperi, în scopul unei modularit ˘at,i crescute s, i unui proces de testare mai facil.

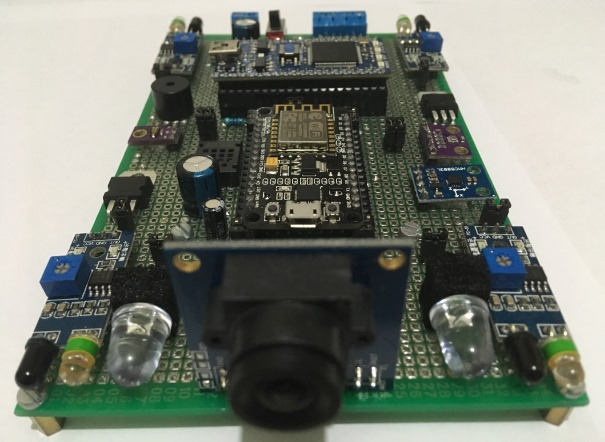
[picture p18: figure]

Figura 2.11: Montajul final – vedere frontal ˘a

În ultimul rând, am prev ˘azut placa cu o diod ˘a LED¹⁹ de 5mm pentru a vedea dac ˘a alimentarea este pornit ˘a accidental atunci când microcontrollerul s, i modulul Wi-Fi nu sunt pe socluri, iar senzorii IR sunt scos, i din funct,iune. Am ad ˘augat, de asemenea, un status LED ce este aprins pân ˘a când pornes,te sistemul de operare sau în cazul producerii unei erori, s, i alte dou ˘a de 10mm cu rol de faruri.

19Light-Emitting Diode

# Capitolul 3

# Implementarea software

Dezvoltarea de software pentru un sistem embedded difer ˘a semnificativ de un calculator obis, nuit, în sensul c ˘a acesta depinde în foarte mare m ˘asur ˘a de hardware-ul acesta îi este destinat, fiind imperios necesar ˘a satisfacerea unor constrângeri de timp s, i de memorie. O caracteristic ˘a important ˘a este c ˘a nu exist ˘a aproape niciodat ˘a o interfat,are direct ˘a a acestuia cu utilizatorul. Comunicat,ia cu exteriorul se realizeaz ˘a în general prin intermediul magistralelor de leg ˘atur ˘a cu alte dispozitive embedded s, i numai în cazuri except,ionale direct cu utilizatorul, în special în scop de depanare sau ajustare a programelor.

Diferent,ele fat, ˘a de sistemele Desktop sunt poate cel mai bine ilustrate în paradigma de dezvoltare a programelor. În timp ce pe un calculator obis, nuit, dezvoltarea de software are loc pe aceeas, i mas, in ˘a pe care codul va fi executat, este improbabil ca un sistem embedded s ˘a aib ˘a resursele necesare pentru o astfel de abordare. Prin urmare, codul surs ˘a al programelor este aproape întotdeauna scris pe un sistem Desktop (engl. host) s, i apoi executat pe dispozitivul embedded c ˘aruia îi este destinat (engl. target). Numeroasele implicat,ii se reflect ˘a în achizit,ia instrumentelor software, ce trebuie s ˘a fie specifice tipului de dispozitiv t,int ˘a, s, i în procesul în sine de dezvoltare. Des, i ciclul normal editare–compilare–depanare se respect ˘a, faza execut,iei induce o complexitate sporit ˘a prin faptul c ˘a programul trebuie transferat pe dispozitivul t,int ˘a sau rulat într-un mediu de simulare. [7]

De asemenea, paradigma execut,iei este întru totul diferit ˘a. Pe un calculator obis, nuit, utilizatorul solicit ˘a sistemului de operare lansarea în execut,ie a unui proces s, i acesta ruleaz ˘a pân ˘a când îs, i duce la îndeplinire sarcina sau este oprit de utilizator, în timp ce dispozitivele embedded ruleaz ˘a software specific la pornire, de obicei citind instruct,iunile direct din memoria nevolatil ˘a. [7]

Capitolul 3. Implementarea software

În timp ce majoritatea programelor dezvoltate pentru sistemele Desktop sunt generice, deci pot fi executate pe o parte considerabil ˘a din calculatoarele existente, specificitatea inerent ˘a dispozitivelor embedded se manifest ˘a s, i în software, mai ales din cauza destinat,iilor extrem de variate ale acestora, dar s, i a deosebirilor tehnice, în special arhitecturi ale procesoarelor, tipuri de periferice sau sisteme de operare diferite.

## 3.1 Limbajul C

Una din put,inele constante caracteristice domeniului este folosirea limbajului de programare C, în clipa de fat, ˘a practica cea mai apropiat ˘a de o norm ˘a a program ˘arii embedded. Fie c ˘a este vorba de de sisteme pe 8 sau 64 de bit,i, cu memorii variind de la cât,iva octet,i la m ˘arimi de ordinul MB, limbajul C reprezint ˘a numitorul comun al software-ului dezvoltat pentru oricare dintre acestea. [8]

Popularitatea remarcabil ˘a a limbajului, evolut,ia lui în timp, dezvoltarea unei multitudini de compilatoare de c ˘atre oameni ce nu au fost implicat,i direct în concept,ia sa, precum s, i necesitatea unei definit,ii precise au dus la crearea, în colaborare cu ISO¹

, a unei serii de standarde sub numele de ANSI² C, al c˘aror obiectiv este "o definit,ie f ˘ar ˘a echivoc s, i hardware–independent ˘a a limbajului". [9]

Avantajele program ˘arii în C a unui dispozitiv embedded sunt remarcabile. Printre acestea se num ˘ar ˘a modelul structurat, num ˘arul mic de termeni rezervat,i (engl. keywords), robustet,ea operatorilor, varietatea tipurilor de date s, i portabilitatea, dispensând programatorul de obligat,ia de a lua în considerare arhitectura procesorului. Însemn ˘atatea cea mai mare, îns ˘a, o are controlul nemijlocit asupra hardware-ului pe care îl ofer ˘a f ˘ar ˘a ca acest lucru s ˘a aduc ˘a cu sine dezavantaje, rezultând un cod mai eficient s, i mai compact comparativ cu limbajele înalte.

Drept consecint, ˘a a generaliz ˘arii ANSI C ca standard de facto al program ˘arii embedded pe parcursul ultimilor ani s, i a considerabilelor avantaje enumerate mai sus, precum s, i din considerente de bun ˘a practic ˘a, am decis utilizarea limbajului C pentru implementarea programului în timp real responsabil de funct,iile de comand ˘a s, i control ale robotului, de prelucrarea s, i asamblarea datelor, precum s, i de rolul decizional în declans, area sistemului de sigurant, ˘a.

1
International Organization for Standardization
2American National Standards Institute

3.2. Procesul de dezvoltare

## 3.2 Procesul de dezvoltare

Dezvoltarea de software pentru dispozitive embedded urmeaz ˘a, în linii mari, trei etape: scrierea codului surs ˘a, translatarea sau cross-compilarea acestuia, ambele având loc pe un calculator (host) s, i depanarea, ce are loc pe dispozitiv (target), urmate de modificarea codului, prin care ciclul se reia. Instrumentele necesare ce corespund acestor stadii cad, de asemenea, în trei categorii: utilitare, constând în editoare text sau medii integrate de dezvoltare (engl. IDE³
), împreun ˘a cu sisteme
de versionare (engl. VCS⁴
), cross-compilatoare s, i instrumente de depanare. [10]

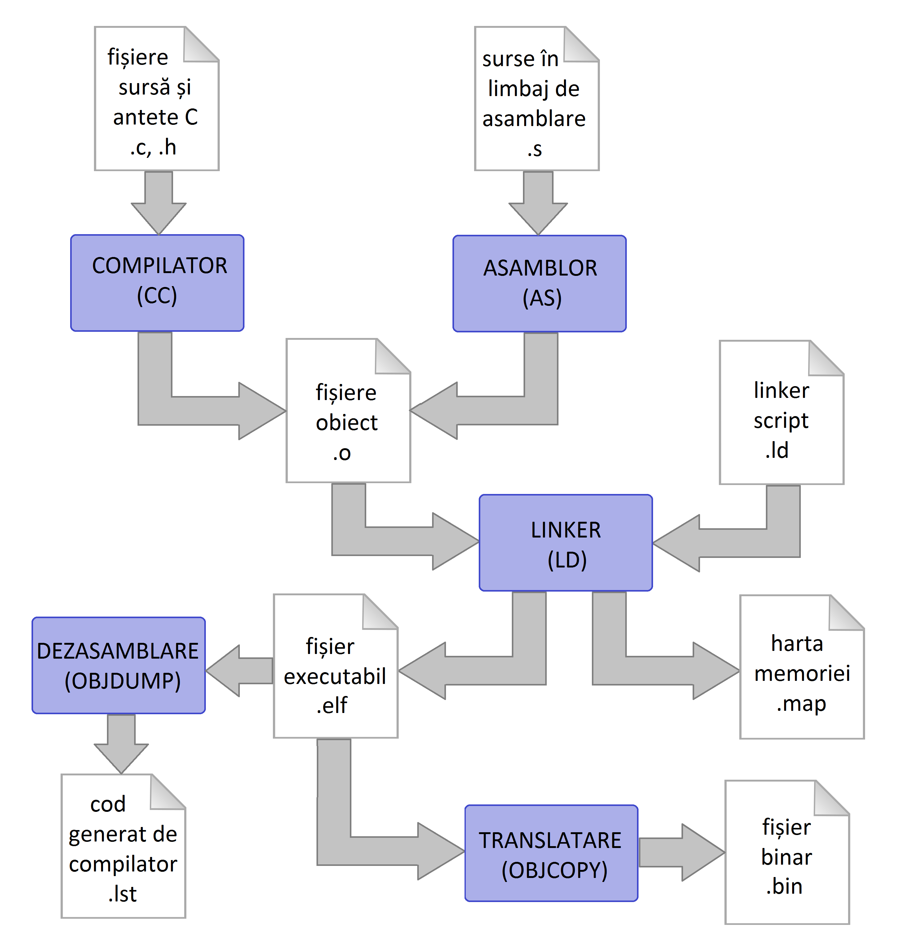
[picture p19: figure]

Figura 3.1: Fazele compil ˘arii pe ARM a programului în timp real

Etapa cea mai complex ˘a tehnic este cross-compilarea, ilustrat ˘a schematic în figura de mai sus, as, a cum se desf ˘as, oar ˘a în cazul proiectului de fat, ˘a. Dup ˘a cum se observ ˘a, procesul este asem ˘an ˘ator compil ˘arii obis, nuite a unui program destinat s ˘a ruleze pe un sistem Desktop. Aceast ˘a similitudine este îns ˘a mai degrab ˘a aparent ˘a decât real ˘a.

3
Integrated Development Environment
4Version Control System

Capitolul 3. Implementarea software

Un cross-compilator integreaz ˘a funct,iile de preprocesare, translatare s, i asamblare a codului surs ˘a în codul mas, in ˘a corespunz ˘ator arhitecturii dorite. În majoritatea cazurilor, anumite p ˘art,i ale programelor embedded sunt scrise manual direct în limbaj de asamblare, de exemplu codul ce se execut ˘a la pornire. Din acest motiv este necesar ˘a prelucrarea separat ˘a a acestora de c ˘atre asamblor. Elementul critic este editorul de leg ˘aturi (linker). Pe lâng ˘a funct,ia obis, nuit ˘a de combinare a modulelor obiect, linker-ul embedded are sarcina de a localiza corect datele s, i codul în memorie, pe baza unui script specificat de programator. Executabilul astfel obt,inut poate fi dezasamblat în scopuri de depanare, în special de a identifica optimiz ˘arile f ˘acute de compilator, sau translatat într-un fis, ier binar ce urmeaz ˘a s ˘a fie mutat s, i executat pe dispozitiv. [10]

Pentru compilarea programului în timp real, destinat s ˘a ruleze pe microcontrollerul LPC1768 am folosit GNU ARM Embedded Toolchain, un compilator performant, capabil de granulat,ia fin ˘a a optimiz ˘arilor de memorie impus ˘a de cerint,ele hardware ale proiectului. De asemenea, având în vedere num ˘arul mare de fis, iere surs ˘a implicate, am decis utilizarea utilitarului GNU Make, în scopul de a automatiza întregul proces.

## 3.3 Arhitectura programului în timp real

Un sistem în timp real nu este neap ˘arat rapid, ci mai degrab ˘a suficient de rapid, cu alte cuvinte determinist sau predictibil. Dat fiind c ˘a nu exist ˘a un interval maxim de timp universal aplicabil în orice situat,ie, sistemele pot fi clasificate în funct,ie tolerant,a la dep ˘as, irea termenelor limit ˘a în sisteme hard real-time sau soft real-time. Aceste categorii semnific ˘a faptul c ˘a un sistem r ˘aspunde la un eveniment înaintea termenului limit ˘a întotdeauna, de exemplu în cazul sistemelor de sigurant, ˘a s, i control, respectiv cu o probabilitate acceptabil ˘a, în majoritatea situat,iilor. În practic ˘a, un sistem embedded complex poate fi încadrat în ambele categorii, în m ˘asura în care anumite p ˘art,i ale sale trebuie s ˘a respecte cu strictet,e constrângerile de timp, în vreme ce alte funct,ionalit ˘at,i mai put,in esent,iale permit un timp de r ˘aspuns aproximativ. Acest lucru are un impact major mai ales asupra alegerii sistemului de operare s, i concept,iei logice a programului. [7]

Arhitectura software propus ˘a în aceast ˘a lucrare este stratificat ˘a s, i are ca element central sistemul de operare FreeRTOS. ARM mbed ofer ˘a un mediu integrat de dezvoltare s, i toate instrumentele necesare, îns ˘a cu pret,ul unui grad de control

3.3. Arhitectura programului în timp real

diminuat asupra software-ului ce ajunge s ˘a fie executat pe dispozitiv. Din acest motiv, precum s, i din cauza necesit ˘at,ii unei conexiuni la internet pentru a profita de aceste avantaje, am decis ca programul în timp real s ˘a fie dezvoltat de sine st ˘at ˘ator, compilat local împreun ˘a cu sistemul de operare s, i driverele periferice s, i legat static cu acestea (engl. bare-metal development). Aceast ˘a abordare s-a dovedit eficient ˘a s, i potrivit ˘a cu nevoia de a exercita un control strict asupra programului înc ˘a din faza de dezvoltare.

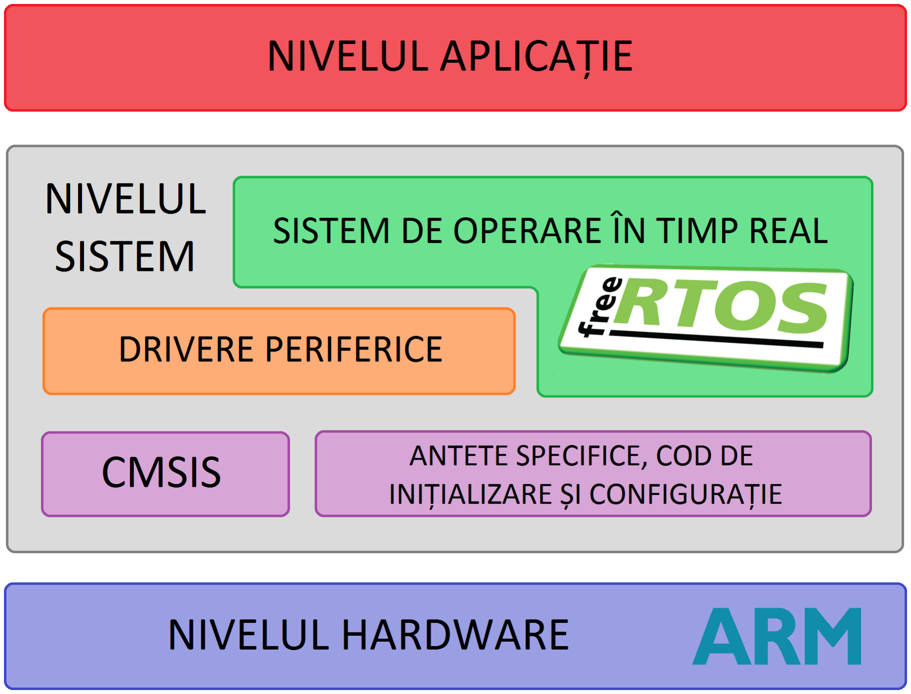
[picture p20: figure]

Figura 3.2: Stiva software a sistemului în timp real

La baza arhitecturii propuse se afl ˘a elemente cu rolul de abstractizare a nivelului hardware, printre care se num ˘ar ˘a antetele specifice platformei, codul de init,ializare, configurat,ia de baz ˘a a dispozitivului s, i definit,iile ARM CMSIS⁵ ,
ce asigur ˘a portabilitatea. Cu un nivel mai sus se afl ˘a driverele periferice s, i sistemul de operare FreeRTOS. Acesta din urm ˘a se situeaz ˘a deasupra driverelor prin faptul c ˘a interact,ioneaz ˘a cu straturile inferioare prin apeluri ale funct,iilor definite de acestea, îns ˘a în acelas, i timp poate fi considerat c ˘a opereaz ˘a la acelas, i nivel, deoarece în anumite cazuri face apel nemijlocit la regis,tri.

Componentele descrise mai sus constituie în ansamblu nivelul sistem, definit ca totalitatea elementelor software ce nu necesit ˘a ajustare în eventualitatea unei modific ˘ari a aplicat,iei. Aceasta se afl ˘a deasupra sa, la vârful stivei, deoarece accesul s ˘au la straturile inferioare nu se poate efectua decât prin intermediul obiectelor sistemului de operare. Aplicat,ia const ˘a într-o serie de fire de execut,ie arbitrate de planificatorul nucleului de timp real (engl. RTK⁶
).

5Cortex Microcontroller Software Interface Standard
6Real-Time Kernel

Capitolul 3. Implementarea software

## 3.4 Kernelul FreeRTOS

Sistemul de operare FreeRTOS este organizat sub forma unui microkernel ce implementeaz ˘a mecanisme de planificare, sincronizare sau comunicare între firele de execut,ie s, i administrare minimal ˘a a memoriei s, i a spat,iului de adrese. Spre deosebire de abordarea clasic ˘a procedural ˘a, concept,ia FreeRTOS este a unui sistem asincron s, i urmeaz ˘a paradigma program ˘arii orientate pe evenimente. Firele de execut,ie, numite taskuri, sunt arbitrate intern în mod dinamic de c ˘atre kernel, pe baza unei ierarhii de priorit ˘at,i furnizate de aplicat,ie. [11]

### 3.4.1 Planificarea

Din punctul de vedere al teoriei complexit ˘at,ii, planificarea unor procese calculabile este o problem ˘a de decizie nedeterminist polinomial complet ˘a (NPC). Rezolvarea unei astfel de probleme netractabile implic ˘a folosirea unor euristici, norm ˘a de la care nici planificarea nu face except,ie. Dat fiind c ˘a este necesar ˘a optimizarea simultan ˘a atât a ordinii taskurilor, cât s, i a sincroniz ˘arii, condit,ionat ˘a s, i de frecvent,a s, i durata schimb ˘arilor de context, se impune folosirea unui algoritm dinamic. [12]

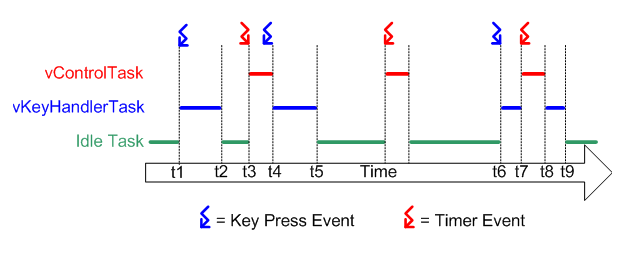
[picture p21: figure]

Figura 3.3: Exemplu de arbitrare a taskurilor în FreeRTOS

Algoritmul de planificare implementat în FreeRTOS intr ˘a în categoria celor cu priorit ˘at,i invariante (engl. fixed-priority scheduling), întrucât priorit ˘at,ile taskurilor sunt atribuite la proiectarea aplicat,iei s, i nu se modific ˘a la rulare (engl. run-time) decât temporar s, i în cazuri except,ionale, exemplificate s, i detaliate în sect,iunea urm ˘atoare. Aceast ˘a abordare are avantajul unei scheme de planificare de o complexitate redus ˘a, deci al vitezei replanific ˘arii s, i schimb ˘arilor de context.

3.4. Kernelul FreeRTOS

Este necesar ˘a, îns ˘a, o atent,ie sporit ˘a la atribuirea init,ial ˘a a priorit ˘at,ilor. Schema priorit ˘at,ilor invariante presupune respectarea urm ˘atoarelor principii:

- Atribuirea priorit ˘at,ii trebuie s ˘a se realizeze în conformitate cu perioada unui task – cu cât perioada este mai mic ˘a, prioritatea acestuia s ˘a fie mai mare.
- Suma procentelor de utilizare a timpului de procesor de c ˘atre fiecare task trebuie s ˘a fie strict mai mic ˘a decât 100%.
- Este necesar s ˘a se stabileasc ˘a în prealabil, prin calcul matematic sau cu ajutorul unor instrumente, dac ˘a problema planific ˘arii curente admite solut,ie.

În anumite cazuri particulare, se poate realiza planificarea unui set de taskuri ce utilizeaz ˘a, în combinat,ie, procesorul la capacitate maxim ˘a, de exemplu prin atribuirea de priorit ˘at,i armonice – perioada oric ˘arui task s ˘a fie egal ˘a cu produsul perioadelor celor cu prioritate mai mic ˘a decât acesta. [13]

Dat fiind c ˘a procesorul nu poate executa decât un singur task la un moment de timp, se impune definirea unui mecanism de st ˘ari pentru a accelera procesul de decizie. Astfel, starea în care un proces ruleaz ˘a este unic ˘a s, i admite maxim un task, în schimb cele nu ruleaz ˘a se pot g ˘asi în st ˘ari diferite.

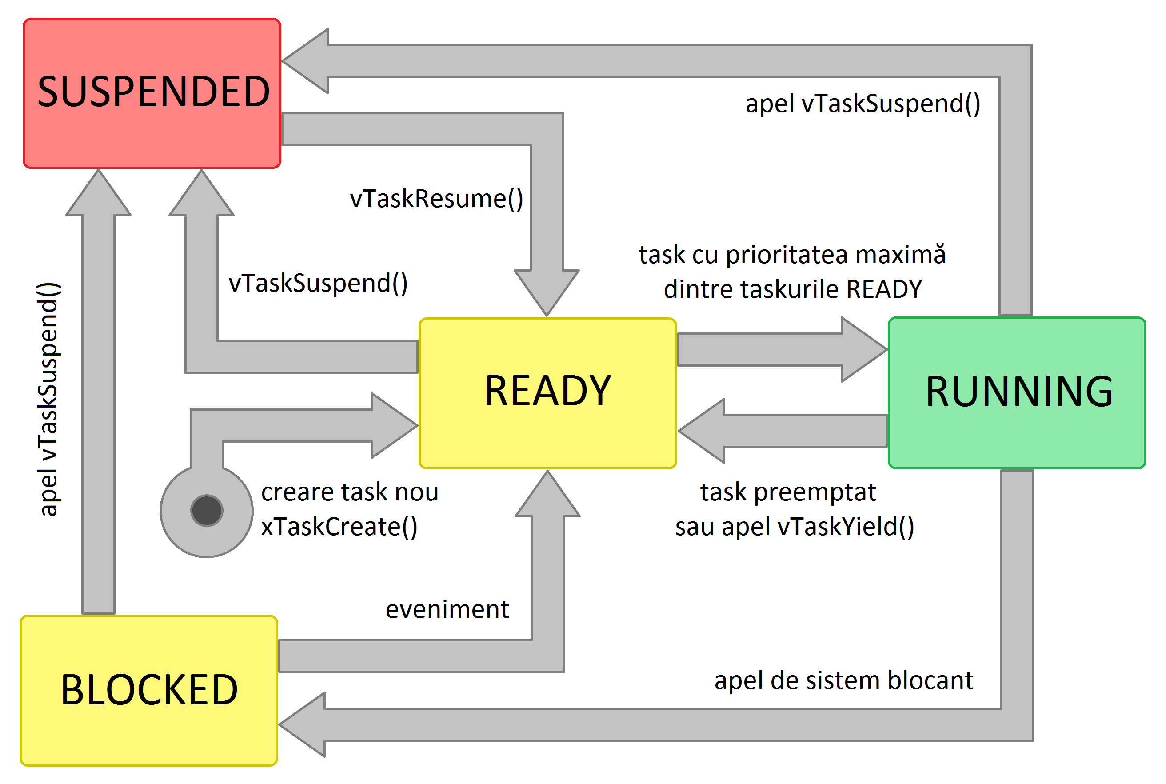
[picture p22: figure]

Figura 3.4: Mecanismul de tranzit,ie între st ˘ari a unui task FreeRTOS

În cazul FreeRTOS, un task se poate g ˘asi la un moment dat într-una din st ˘arile Running, Ready, Suspended sau Blocked. În starea Running se afl ˘a doar taskul care

Capitolul 3. Implementarea software

ruleaz ˘a în mod curent s, i poate r ˘amâne în aceasta doar dac ˘a prioritatea sa este mai mare decât priorit ˘at,ile celor din starea Ready. Aceasta caracterizeaz ˘a toate taskurile care pot fi executate la un moment de timp, cu alte cuvinte cele a c ˘aror execut,ie nu depinde momentan de factori externi. Suspended este starea în care se afl ˘a procesele oprite, iar în starea Blocked se g ˘asesc acele taskuri care as,teapt ˘a producerea unui eveniment sau eliberarea unei resurse. [14]

Prin respectarea principiilor de atribuire a priorit ˘at,ilor amintite mai devreme s, i t,inând seama de mecanismul bine definit de tranzit,ie între st ˘ari pot fi evitate erori de planificare, precum situat,ia unui task de prioritate mic ˘a care nu ajunge niciodat ˘a s ˘a fie executat (engl. processor starvation).

### 3.4.2 Administrarea resurselor

Într-un sistem cu procese multiple, accesul concurent la resurse poate cauza conflicte. Un exemplu este situat,ia în care un task realizeaz ˘a înainte de a ies, i din starea Running un acces incomplet la o resurs ˘a, iar aceasta este accesat ˘a de c ˘atre alt task înainte ca primul s ˘a ajung ˘a din nou s ˘a se execute. Starea inconsistent ˘a în care resursa ajunge astfel poate rezulta în coruperea datelor sau erori similare.

Pentru evitarea acestor conflicte se folosesc mecanisme de sincronizare s, i obiecte puse la dispozit,ie de c ˘atre sistemul de operare. În scopul de a limita accesul concurent al prea multor taskuri la o resurs ˘a, FreeRTOS ofer ˘a cozi s, i semafoare de tip contor, iar pentru excluderea mutual ˘a, semafoare binare sau mutex. Utilizarea incorect ˘a a acestora poate cauza, îns ˘a, situat,ii except,ionale de tipul inversiunii de priorit ˘at,i. [14]

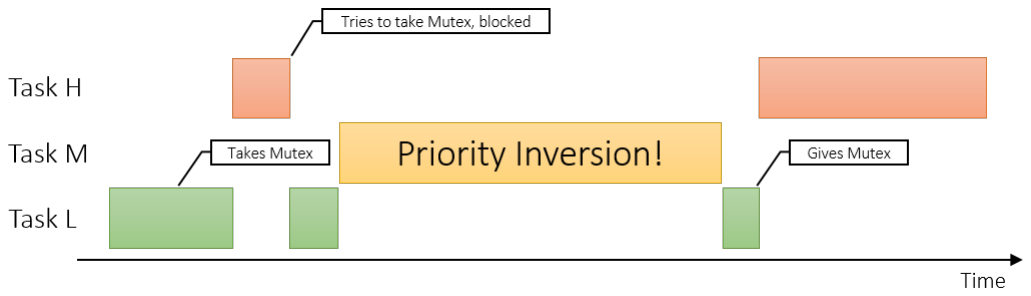
[picture p23: figure]

Figura 3.5: Fenomenul de inversiune a priorit ˘at,ilor

Inversiunea priorit ˘at,ilor se defines,te ca întârzierea accidental ˘a a execut,iei unui task de c ˘atre un alt task de prioritate mai mic ˘a ce det,ine accesul exclusiv la o resurs ˘a necesar ˘a primului. Ilustrat în figura de mai sus este cazul cel mai

3.4. Kernelul FreeRTOS

defavorabil, în care al doilea task poate fi întrerupt la rândul s ˘au, ducând la întârzieri inadmisibile. Fenomenul se poate petrece s, i în cazul folosirii cozilor sau altor obiecte similare. Solut,ia la aceast ˘a problem ˘a este mecanismul de mos,tenire a priorit ˘at,ii, a c ˘arui funct,ionare este exemplificat ˘a mai jos.

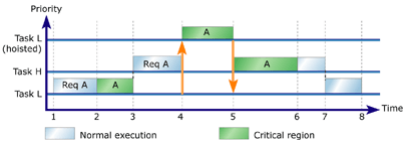
[picture p24: figure]

Figura 3.6: Mecanismul de mos,tenire a priorit ˘at,ii

Aceast ˘a abordare presupune atribuirea unei priorit ˘at,i mai mari decât cele ale taskurilor fiec ˘arei resurse partajate. Astfel, în situat,ia în care un task ce det,ine accesul exclusiv la o resurs ˘a este întrerupt de altul concurent, de prioritate mai mare, primul va fi temporar în ˘alt,at (engl. hoisted) la prioritatea resursei, revenind la modul normal de funct,ionare dup ˘a eliberarea acesteia. În cazul accesului simultan la mai multe resurse vor fi implicate în mos,tenire doar cele disputate.

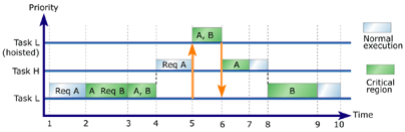
[picture p25: figure]

Figura 3.7: Mos,tenirea priorit ˘at,ii în cazul resurselor multiple

Din acest punct de vedere FreeRTOS face diferent,a între semafoare binare s, i mutex. Un mutex ofer ˘a un grad de încredere mai ridicat deoarece implementeaz ˘a mecanismul de mos,tenire a priorit ˘at,ii, spre deosebire de un semafor binar, care este în general folosit pentru semnalarea între taskuri.O alt ˘a metod ˘a recomandat ˘a de a asigura accesul exclusiv la o resurs ˘a este definirea unui task special numit gatekeeper, cu rolul de a intermedia o resurs ˘a partajat ˘a cu taskurile ce o utilizeaz ˘a. Astfel, un acces la resurs ˘a se va transforma într-un mesaj c ˘atre taskul gatekeeper, ce det,ine accesul exclusiv s, i neîntrerupt la resursa în cauz ˘a. [14]

Capitolul 3. Implementarea software

## 3.5 Descriere funct,ional ˘a

Datorit ˘a caracteristicilor esent,iale ale FreeRTOS, zugr ˘avite pe scurt în subcapitolul precedent, a fost posibil˘a dezvoltarea unei aplicat,ii ce funct,ioneaz ˘a secvent,ial numai într-o prim ˘a etap ˘a, executându-se apoi complet asincron o dat ˘a cu pornirea sistemului de operare. St ˘arile pe care le traverseaz ˘a sistemul dup ˘a pornirea aliment ˘arii pot fi rezumate dup ˘a cum urmeaz ˘a:

- Init,ializarea procesorului s, i a memoriei
- Configurarea perifericelor PWM, GPIO⁷
, ADC, UART s, i I2C
- O scurt ˘a perioad ˘a de as,teptare pentru a avea sigurant,a c ˘a toate celelalte dispozitive au fost init,ializate
- Stingerea LED-ului indicator de stare
- Pornirea taskurilor s, i a planificatorului FreeRTOS

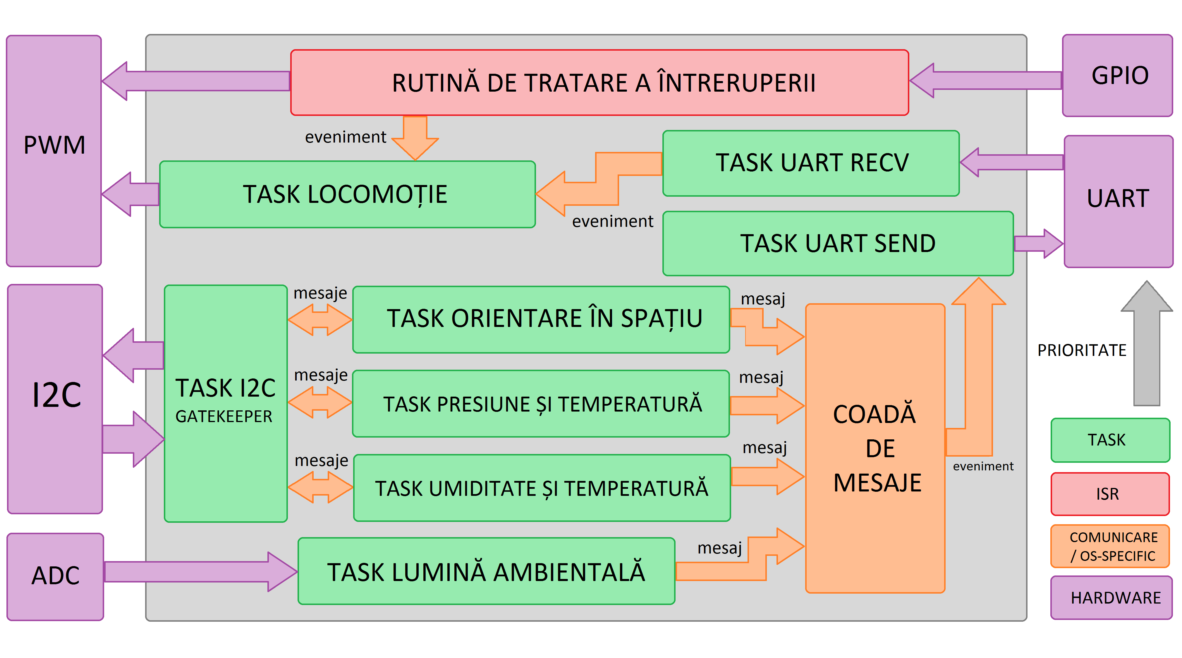
[picture p26: figure]

Figura 3.8: Organizarea taskurilor în aplicat,ia real-time

Dup ˘a traversarea etapei init,iale, taskurile intr ˘a în bucl ˘a infinit ˘a se execut ˘a asincron s, i interact,ioneaz ˘a cu hardware-ul sau între ele ca în figura de mai sus. Am definit taskuri separate pentru locomot,ie s, i pentru interfat,area fiec ˘arui senzor, precum s, i trei taskuri gatekeeper corespunz ˘atoare transmisiei s, i recept,iei UART, respectiv magistralei I2C. Caracterul critic al sistemului de sigurant, ˘a a impus implementarea sa sub forma unei rutine de tratare a unei întreruperi externe s, i înregistrarea semnalelor primite de la senzorii de proximitate.

7General-Purpose Input/Output

3.6. Transferul de date

Execut,ia taskurilor responsabile de comunicat,ia cu senzorii de mediu s, i interpretarea m ˘asur ˘atorilor, acolo unde este nevoie, este periodic ˘a la intervale strâns corelate cu prioritatea s, i durata fiec ˘areia s, i controlat ˘a în baza acestor parametri de kernelul FreeRTOS. Datele sunt primite de la gatekeeper-ul magistralei I2C s, i expediate printr-o coad ˘a de mesaje c ˘atre cel responsabil de transmisia pe UART. Dac ˘a exist ˘a m ˘asur ˘atori ce nu au fost înc ˘a transmise, se acord ˘a prioritate acestui lucru în detrimentul înregistr ˘arii de noi date.

Locomot,ia este tratat ˘a de un task dedicat ce este notificat asupra comenzilor de deplasare prin evenimente de c ˘atre gatekeeper-ul receptor UART ce interpreteaz ˘a comenzile. În cazul în care pe direct,ia de deplasare exist ˘a un obstacol va fi declans, at ˘a întreruperea extern ˘a ce act,ioneaz ˘a direct spre oprirea robotului s, i invalideaz ˘a temporar printr-un semnal c ˘atre taskul responsabil cu locomot,ia orice comenzi ce presupun apropierea de obstacol. Pentru asigurarea unei mis, c ˘ari uniforme, acesta din urm ˘a este pus în as,teptarea unui eveniment sau a unei perioade marginal mai mari decât intervalul minim dintre dou ˘a comenzi succesive.

## 3.6 Transferul de date

Transferul de date între microcontroller, ce trimite datele pe magistrala serial ˘a UART, s, i calculator, ce le recept,ioneaz ˘a prin protocolul IEEE⁸ 802.11, se realizeaz ˘a prin intermediul modulului Wi-Fi din dotarea robotului. Deoarece în cazul transferului de date nu este critic ˘a respectarea constrângerilor stringente de timp real caracteristice aplicat,iei de control s, i având în vedere necesitatea de a implementa funct,ionalit ˘at,i complexe, dar comparativ put,ine, am decis utilizarea unui bootloader Arduino pentru programare mai convenabil ˘a s, i acces facil la funct,ii de bibliotec ˘a. Modulul are asociat ˘a o adres ˘a IP static ˘a s, i init,ial as,teapt ˘a un semnal de la microcontroller, apoi ascult ˘a pe portul UDP pân ˘a când primes,te un pachet de la calculator.

Dup ˘a a fost recept,ionat acest pachet, este identificat ˘a adresa IP a clientului s, i începe transferul. Datele primite pe interfat,a serial ˘a sunt transmise mai departe ca pachete UDP c ˘atre respectiva adres ˘a, iar comenzile primite prin Wi-Fi sunt expediate, în sens invers, pe magistrala serial ˘a. Dac ˘a adresa IP a calculatorului se modific ˘a între timp, aceasta va fi actualizat ˘a la primirea urm ˘atorului pachet s, i traficul de date va fi redirectat.

8
Institute of Electrical and Electronics Engineers

Capitolul 3. Implementarea software

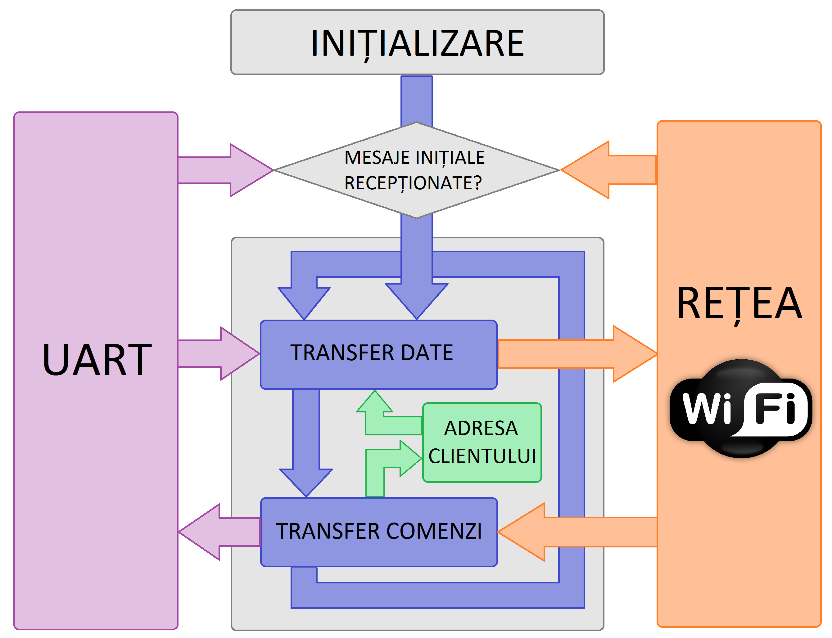
[picture p27: figure]

Figura 3.9: Reprezentare schematic ˘a a transferului de date

As, a cum am ment,ionat în capitolul precedent, nu a fost posibil ˘a utilizarea capabilit ˘at,ilor hardware pentru UART din cauza unei imperfect,iuni a modulului. Drept urmare, a fost folosit ˘a o implementare în software ce stabiles,te s, i es, antioneaz ˘a în mod direct st ˘arile a doi pini GPIO, cu condit,ia ca cel put,in unul dintre aces,tia s ˘a suporte întreruperi externe. Aceast ˘a tehnic ˘a este cunoscut ˘a sub numele de bit banging s, i presupune controlul direct din software al nivelului logic, sincroniz ˘arii s, i altor parametri ai semnalului.

## 3.7 Interfat,a cu utilizatorul

Interfat,a cu utilizatorul a fost realizat˘a sub forma unui script Python ce se conecteaz ˘a la modulul Wi-Fi al robotului. În urma stabilirii unei conexiuni, acesta înregistreaz ˘a la fiecare 200ms tasta ap ˘asat ˘a, corespunz ˘atoare direct,iei de deplasare dorite, s, i trimite mai departe c ˘atre robot comenzile de deplasare corespunz ˘atoare sub forma unor pachete UDP. Simultan sunt recept,ionate pachetele de date ce reprezint ˘a parametrii caracteristici mediului m ˘asurat,i de senzorii robotului.

Scriptul p ˘astreaz ˘a în memorie cele mai recente date primite de fiecare tip s, i actualizeaz ˘a valorile afis, ate de fiecare dat ˘a când una dintre acestea se modific ˘a. De asemenea, în plus fat, ˘a de parametrii de mediu, în interfat,a grafic ˘a apar intervalul de timp de când sistemul de operare a pornit s, i în eventualitatea producerii unei erori, o scurt ˘a descriere a naturii acesteia.

# Capitolul 4

# Rezultate experimentale

Testele efectuate au ar ˘atat c ˘a robotul se comport ˘a conform as,tept ˘arilor s, i r ˘aspunde, atât la comenzi, cât s, i la modific ˘ari ale parametrilor mediului înconjur ˘ator, f ˘ar ˘a întârzieri semnificative. Am verificat, de asemenea, declans, area sistemului de sigurant, ˘a în cazul întâlnirii unor obstacole s, i am constatat c ˘a funct,ioneaz ˘a corect pentru mai multe tipuri ale acestora, îns ˘a este necesar ˘a calibrarea senzorilor de proximitate la fiecare pornire a robotului prin reglarea potent,iometrelor.

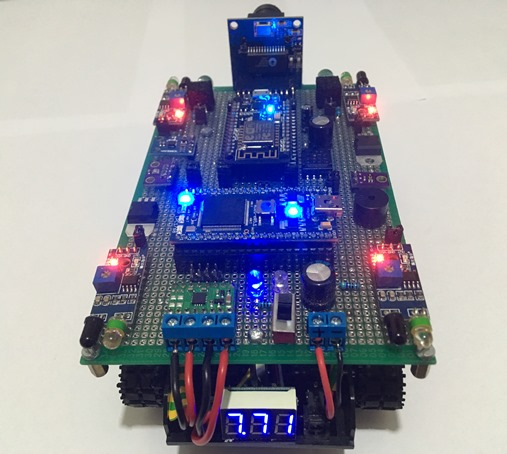
[picture p28: figure]

Figura 4.1: Robotul aflat în funct,iune

Capitolul 4. Rezultate experimentale

Pentru a demonstra caracterul asincron al aplicat,iei, am programat aprinderea câte unui LED pentru fiecare tip de task, pe durata execut,iei acestuia, s, i am observat astfel în timp real modificarea ponderii fiec ˘arei funct,ionalit ˘at,i în funct,ie de circumstant,e, în termen de timp de rulare pe procesor.

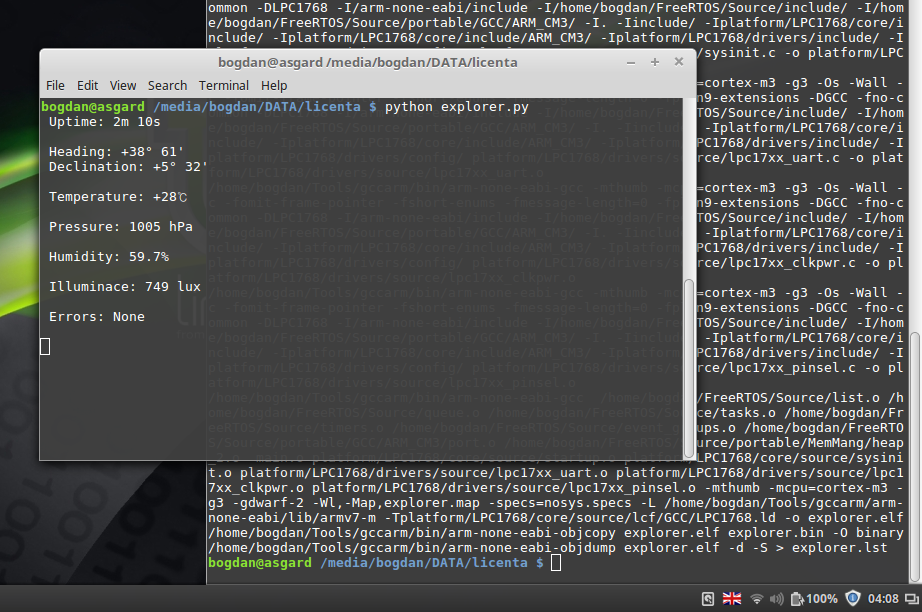
[picture p29: figure]

Figura 4.2: Interfat,a cu utilizatorul

Am constatat c ˘a transferul datelor se realizeaz ˘a corect s, i raza de transmisie este confortabil de mare, atâta timp cât nu este obstruct,ionat ˘a de prea mult,i peret,i sau ferestre. În acest scop, am folosit timpul de funct,ionare (uptime) trimis periodic de robot ca un mecanism heartbeat, recept,ia constant ˘a a acestuia constituind un indicator al funct,ion ˘arii normale.

Necesitatea de a implementa interfat,a serial ˘a a modulului Wi-Fi în software, folosind doi pini GPIO diferit,i de cei dedicat,i nu a l ˘asat suficiente linii disponibile pentru citirea datelor de la camera video, nici chiar în condit,iile în care comanda acesteia cade în sarcina microcontrollerului. Drept urmare, aceast ˘a funct,ionalitate nu a putut fi inclus ˘a în proiect, fiind nevoie de modific ˘ari radicale ale arhitecturii robotului.

# Capitolul 5

# Concluzii s

,

# i dezvoltare ulterioar ˘a

Obiectivele acestei lucr ˘ari au fost proiectarea s, i programarea unui robot explorator într-un mod ce asigur ˘a decizii autonome în situat,ii de risc s, i garanteaz ˘a un r ˘aspuns în timp real la comenzi s, i stimuli exteriori. Arhitectura modular ˘a propus ˘a s-a dovedit a fi potrivit ˘a acestui tip de problem ˘a s, i confer ˘a un grad înalt de flexibilitate. De asemenea, rezultatele experimentale au demonstrat c ˘a integrarea aplicat,iei de control cu sistemul de operare în timp real FreeRTOS constituie o abordare nu numai elegant ˘a, dar s, i eficient ˘a. Aceste aspecte atest ˘a succesul implement ˘arii funct,iilor esent,iale ale unui robot explorator s, i stabilesc un punct solid de plecare pentru cercet ˘arile viitoare în domeniu.

În continuare se au în vedere posibile dezvolt ˘ari ulterioare având ca obiect atât arhitectura hardware, cât s, i funct,iile implementate în software. O prim ˘a direct,ie de dezvoltare poate fi înlocuirea modulului Wi-Fi cu o alt ˘a pies ˘a similar ˘a, ceea ce ar face posibil ˘a transmisia unui flux de imagini dinspre robot c ˘atre operator cu un num ˘ar suficient de cadre pe secund ˘a, astfel încât aceast ˘a funct,ionalitate s ˘a fie cu adev ˘arat util ˘a la explorarea spat,iilor altfel inaccesibile.

De asemenea, robotul ar putea nu numai s ˘a transmit ˘a m ˘asur ˘atori în timp real, dar s, i s ˘a înregistreze aceste date într-o memorie nevolatil ˘a, de exemplu un card SD, oferind astfel posibilitatea realiz ˘arii unor grafice s, i statistici ale variat,iei parametrilor.

O funct,ionalitate nou ˘a ce nu presupune modificarea hardware-ului existent poate fi dezvoltarea unei aplicat,ii de comand˘a s, i control pe un telefon mobil, în scopul unei utiliz ˘ari mai convenabile s, i mai flexibile.

# Bibliografie

[1] N. Sharkey, A programmable robot from AD 60, New Scientist, 2007.
[2] M. Wall, A Glitch Nearly Killed NASA’s Curiosity Rover After 6 Months on Mars, 2017. Disponibil pe www.space.com (https://www.space.com/36841-mars-rover-curiosity-computer-glitch-60-minutes.html) (15.05.2017)
[3] R. Richardson, et al. The “Djedi” Robot Exploration of the Southern Shaft of the Queen’s Chamber in the Great Pyramid of Giza, Egypt, Journal of Field Robotics 30(3): 323–348, 2013.
[4] M.Wolf, High-Performance Embedded Computing: Applications in Cyber-Physical Systems and Mobile Computing, Second Edition, Elsevier, 2014
[5] R. Oshana, M. Kraeling, Software Engineering for Embedded Systems: Methods, Practical Techniques, and Applications, Elsevier, 2013
[6] R. Toulson, T. Wilmshurst, Fast and Effective Embedded Systems Design – Applying the ARM mbed, Elsevier, 2012
[7] C. Walls, Embedded Software: The Works, Second Edition, Elsevier, 2012
[8] M. Barr, Programming Embedded Systems in C and C++, O’Reilly, 1999
[9] B. Kernighan, D. Ritchie, The C programming Language, Second Edition, Prentice-Hall, 1988
[10] T. Noergaard, Embedded Systems Architecture, Elsevier, 2013
[11] R. Barry, Using the FreeRTOS Real Time Kernel, Real Time Engineers Ltd, 2010
[12] E. Lee, S. Seshia, Introduction to Embedded Systems – A Cyber-Physical Systems Approach, LeeSeshia.org, 2011
[13] J. Yiu, The Definitive Guide to ARM Cortex–M3 and Cortex–M4 Processors, Third Edition, Elsevier, 2014
[14] R. Barry, Mastering the FreeRTOS Real Time Kernel, Real Time Engineers Ltd, 2016

# List ˘a de figuri

1.1 Robotul explorator Curiosity al NASA
Sursa: www.jpl.nasa.gov (https://www.jpl.nasa.gov/spaceimages/details.php?id=PIA09201) (15.05.2017) | 5
1.2 Robotul urban Urbie Rover al NASA
Sursa: www.jpl.nasa.gov (https://www.jpl.nasa.gov/news/news.php?feature=485) (16.05.2017) | 6
1.3 Robotul explorator Djedi
Sursa: archive.archaeology.org (http://archive.archaeology.org/1109/trenches/djedi_project_robot_pyramid_khufu_palenque.html) (20.05.2017) | | 7
2.1 Schema bloc a sistemului | | 9
2.2 Platforma NXP mbed LPC1768 | 11
2.3 S, asiul robotului s, i motoarele | 12
2.4 Exemplu de punte H | 13
2.5 Puntea de motoare DRV8833
Sursa: www.pololu.com (https://www.pololu.com/product/2130/pictures#lightbox-picture0J3867) (12.04.2017) | 14
2.6 Principiul de funct,ionare al unui senzor de proximitate IR
Sursa: www.maxembedded.com (https://maxembedded.files.wordpress.com/2013/07/ir-sensor-illustration.png?resize=470%2C329) (27.04.2017) | 15
2.7 Sistem de calcul s, i achizit,ie a datelor în timp real | 17
2.8 Camera video OV7670 | 19
2.9 Platforma NodeMCU DEVKIT v1.0 | 20
2.10 Montajul final – vedere lateral ˘a | 21
2.11 Montajul final – vedere frontal ˘a | 22
3.1 Fazele compil ˘arii pe ARM a programului în timp real | 25
3.2 Stiva software a sistemului în timp real | 27
3.3 Exemplu de arbitrare a taskurilor în FreeRTOS
Sursa: www.freertos.org (http://www.freertos.org/implementation/RTExample.gif) (10.06.2017) | 28
3.4 Mecanismul de tranzit,ie între st ˘ari a unui task FreeRTOS | 29
3.5 Fenomenul de inversiune a priorit ˘at,ilor
Sursa: www.percepio.com (https://percepio.com/wp-content/uploads/2016/03/1.-priority-inversion.png) (16.06.2017) | 30

List ˘a de figuri

3.6 Mecanismul de mos,tenire a priorit ˘at,ii
Sursa: www.embedded.com (http://m.eet.com/media/1075483/0406feat3fig5.gif) (20.06.2017) | 31
3.7 Mos,tenirea priorit ˘at,ii în cazul resurselor multiple
Sursa: www.embedded.com (http://m.eet.com/media/1075486/0406feat3fig8.gif) (20.06.2017) | 31
3.8 Organizarea taskurilor în aplicat,ia real-time | 32
3.9 Reprezentare schematic ˘a a transferului de date | 34
4.1 Robotul aflat în funct,iune | 35
4.2 Interfat,a cu utilizatorul | 36

# Anexa A

# Schema electric ˘a
