bogdan-folea/explorer/doc/figuri/djedi.png

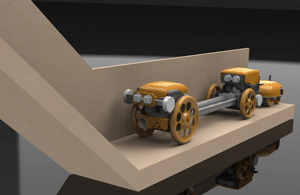
doc/figuri/djedi.png
