bogdan-folea/explorer/doc/figuri/invers.png

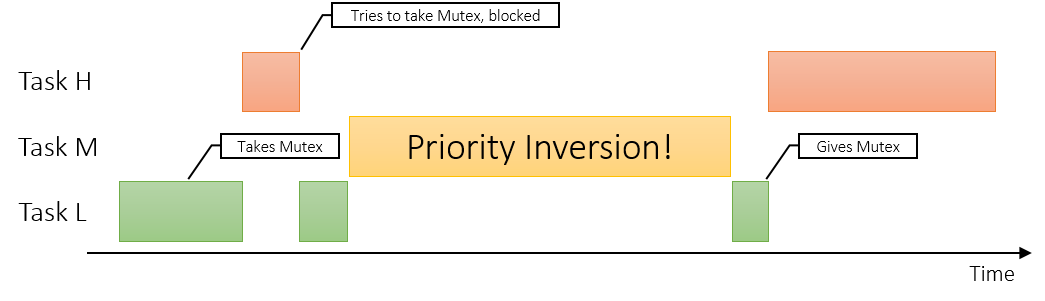
doc/figuri/invers.png
