bogdan-folea/explorer/doc/figuri/mostenire2.png

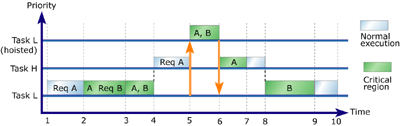
doc/figuri/mostenire2.png
