bogdan-folea/explorer/doc/figuri/punteh.png

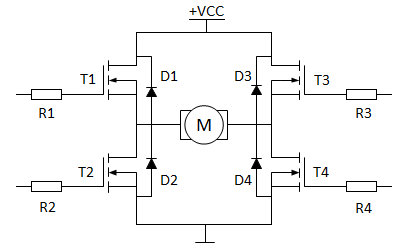
doc/figuri/punteh.png
