bogdan-folea/explorer/doc/figuri/sasiu.jpg

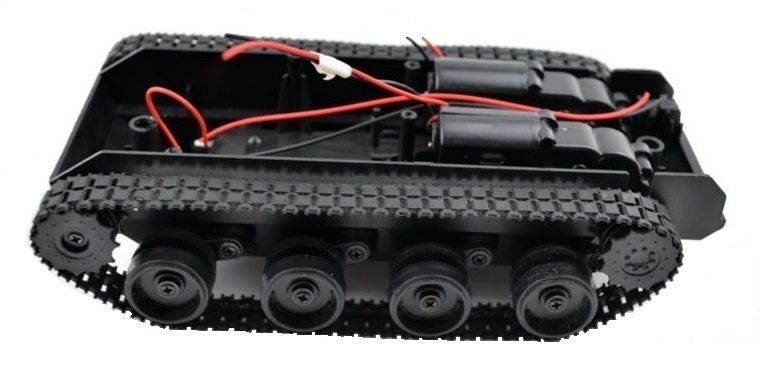
doc/figuri/sasiu.jpg
