bogdan-folea/explorer/doc/figuri/software.png

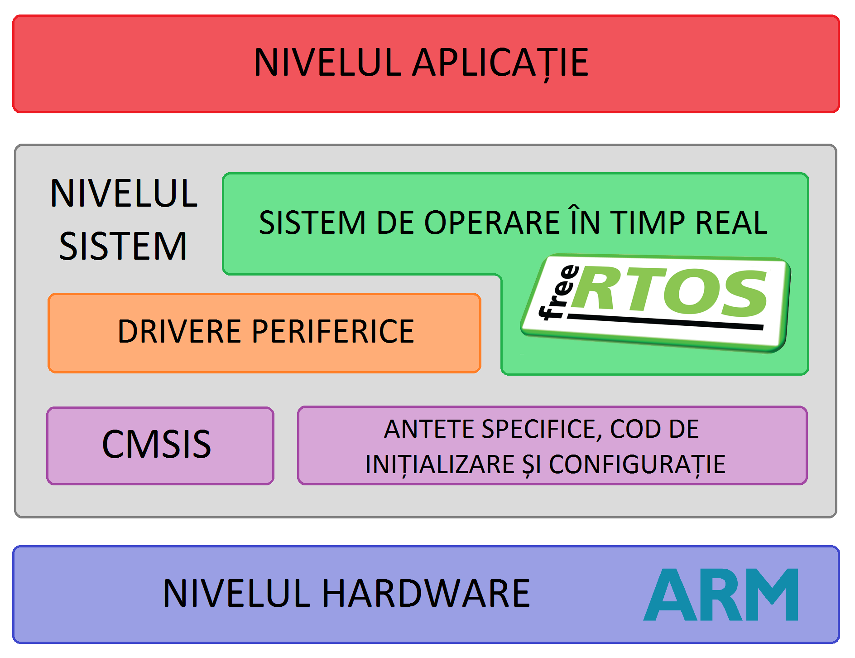
doc/figuri/software.png
