bogdan-folea/explorer/doc/figuri/montaj.jpg

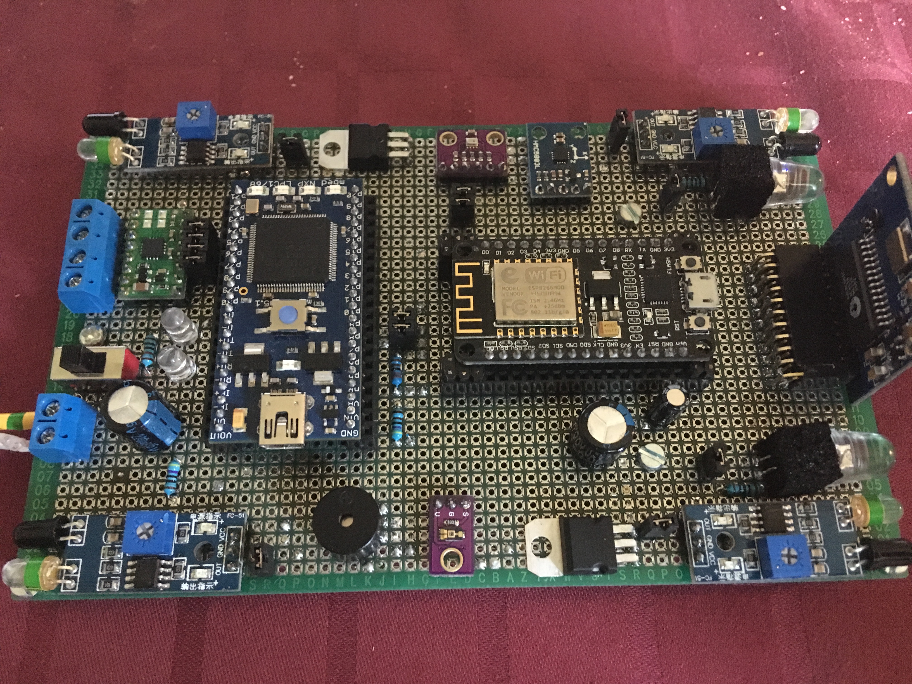
doc/figuri/montaj.jpg
