bogdan-folea/explorer/(commit log)

2017-04-19 Added LPC1768 drivers
2017-07-04 working w/o I2C
